FOSSASystems/FOSSASAT-1/Hardware/Pictures/a31cf8a4eafdad409a6d113227be1326.jpg

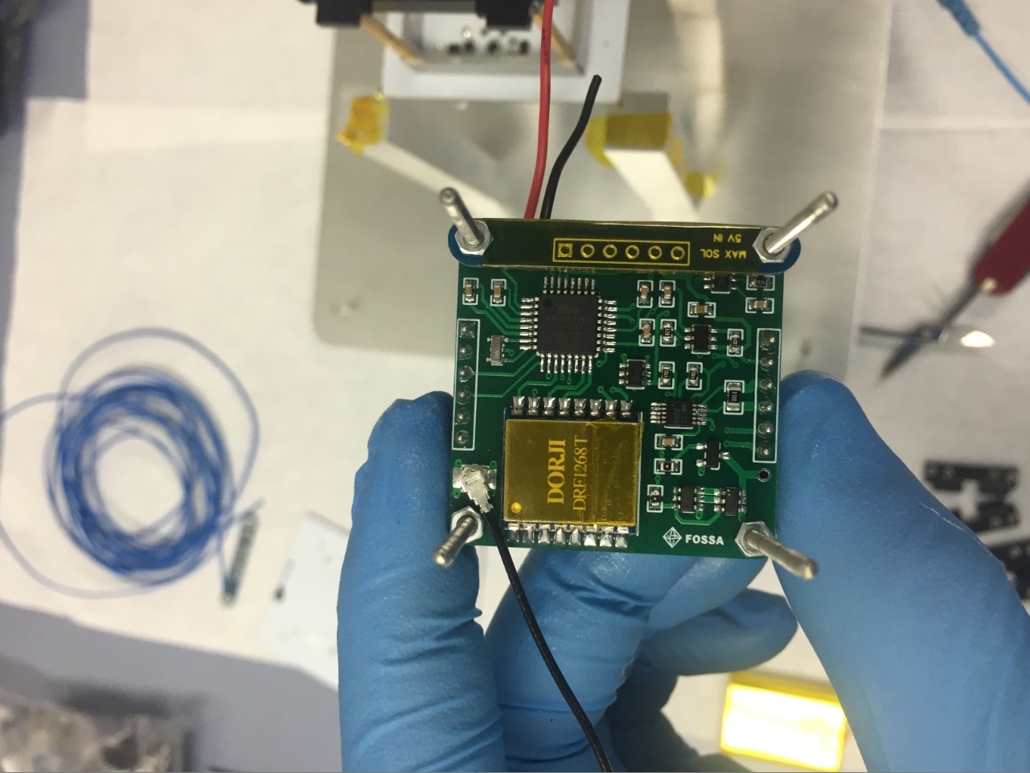
Hardware/Pictures/a31cf8a4eafdad409a6d113227be1326.jpg
