FOSSASystems/FOSSASAT-1/Hardware/Pictures/7ddb9faa-3a29-4a0a-8007-f152b679b4c5.jpg

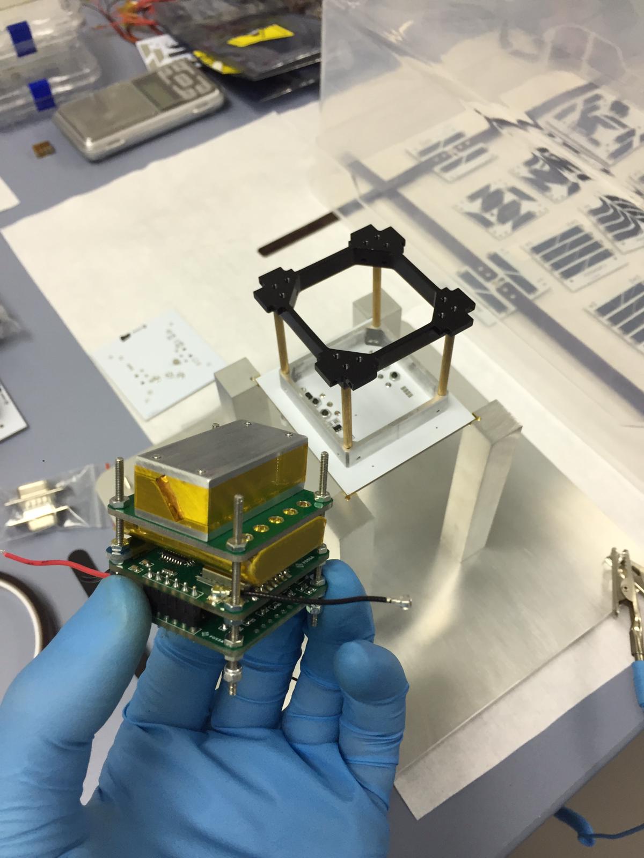
Hardware/Pictures/7ddb9faa-3a29-4a0a-8007-f152b679b4c5.jpg
