FOSSASystems/FOSSASAT-1/Hardware/Passive Attitude Stab/README.md

Two 3x10mm cylindrical magnets are held in the ballast at 55º to compensate for magnetic inclination of Spain. Four MuMetal strips are held on the side pcbs.
