FOSSASystems/FOSSASAT-1/Hardware/Power/README.md

An SPV1040 will be used to regulate the incoming voltage from 14 solar panels with MPPT for float charging, each with 8 trisol X 2.3v 14.6mw solar cells. Corresponding bypass and blocking diodes are used. A 3.7v Li-Ion 1000mah battery will be used. A regulated 3.3v bus will is supplied by a Linear Voltage regulator.
