FOSSASystems/FOSSASAT-1/Code/Documentation/Ground Station/doxygen documentation/latex/ground__station_8cpp__incl.pdf

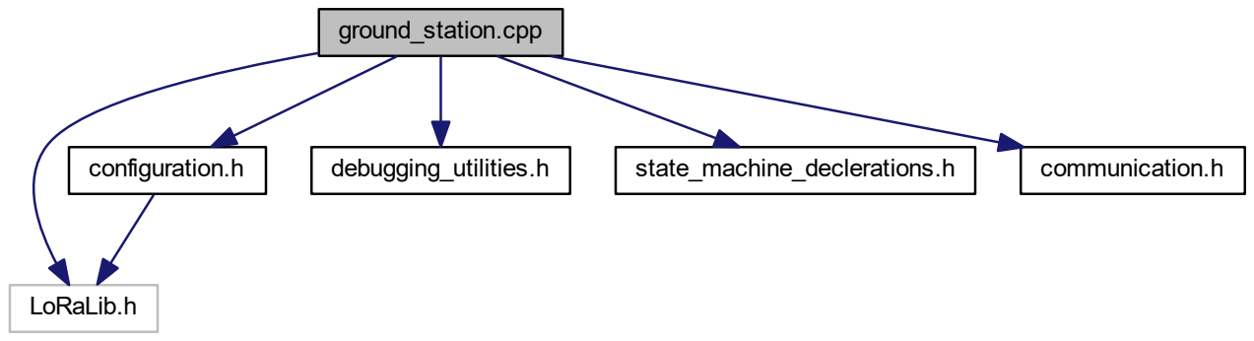
[picture p9: figure]
ground_station.cpp; LoRaLib.h; configuration.h; debugging_utilities.h; state_machine_declerations.h; communication.h
