FOSSASystems/FOSSASAT-1/Code/Documentation/Ground Station/doxygen documentation/latex/communication_8cpp__incl.pdf

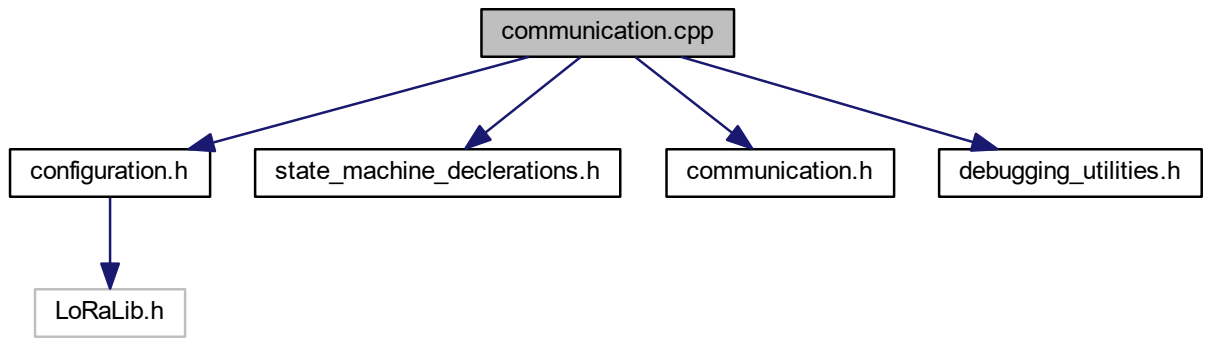
[picture p14: figure]
communication.cpp; configuration.h; state_machine_declerations.h; communication.h; debugging_utilities.h; LoRaLib.h
