FOSSASystems/FOSSASAT-1/FOSSA Documents/Software Documentation/Graphs/FOSSASAT-1.png

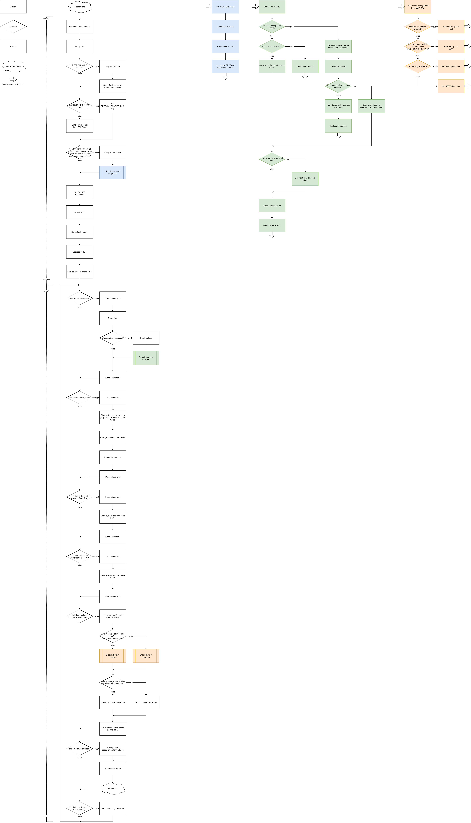
FOSSA Documents/Software Documentation/Graphs/FOSSASAT-1.png
