FOSSASystems/FOSSASAT-1/FOSSA STK/DOPPLER/GRAPHS/FOSSA_DOPPLER_2ELEV.png

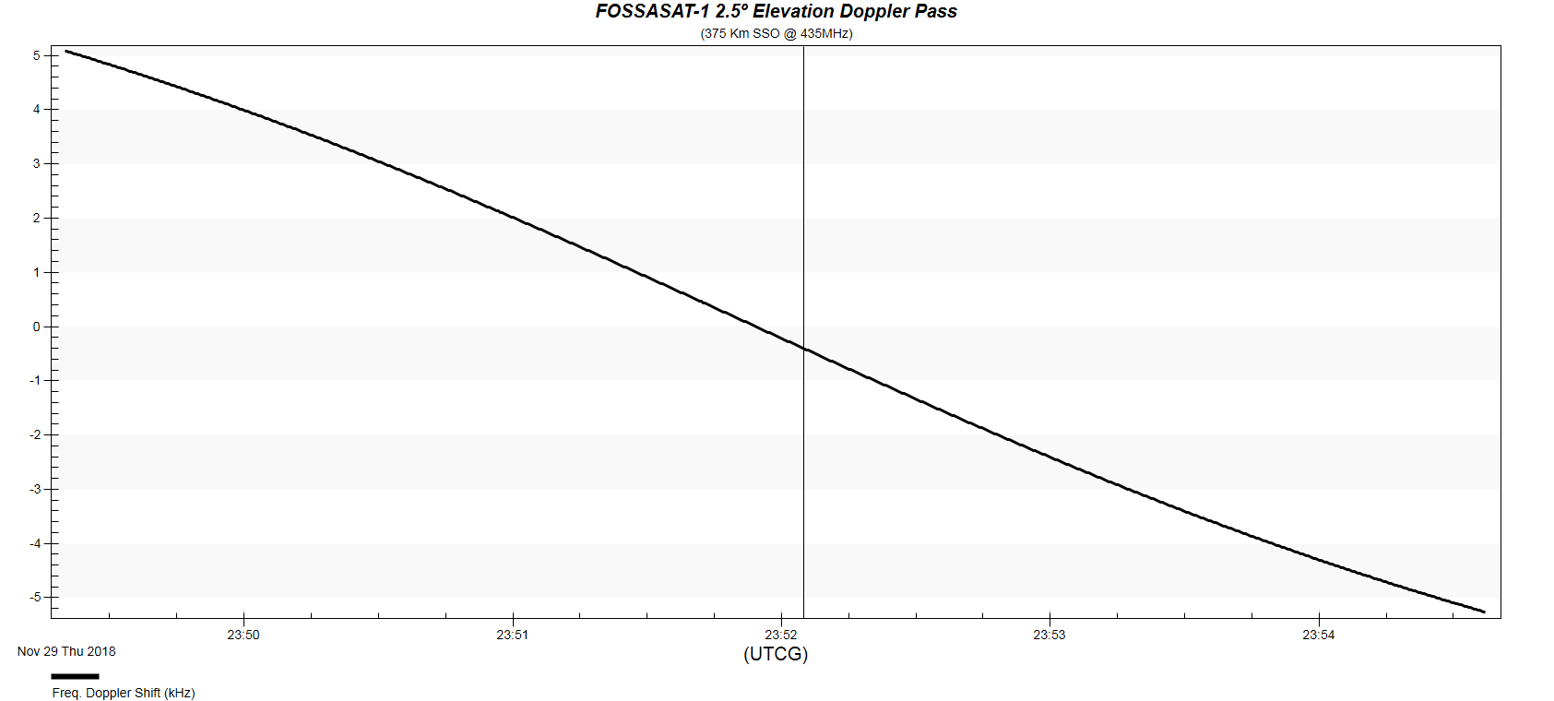
FOSSA STK/DOPPLER/GRAPHS/FOSSA_DOPPLER_2ELEV.png
