FOSSASystems/FOSSASAT-1/FOSSA STK/DOPPLER/GRAPHS/FOSSA_DOPPLER_12ELEV.png

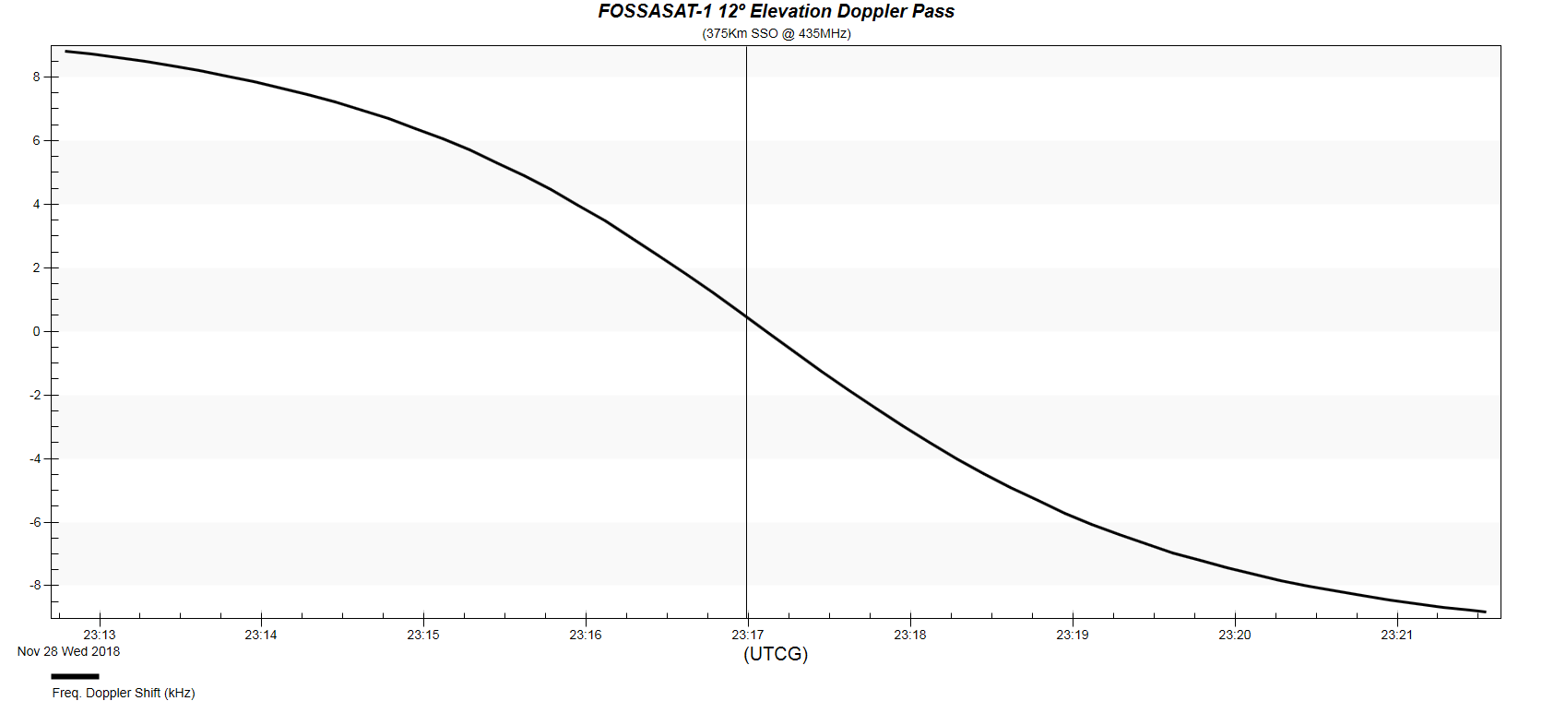
FOSSA STK/DOPPLER/GRAPHS/FOSSA_DOPPLER_12ELEV.png
