FOSSASystems/FOSSASAT-1/FOSSA STK/DOPPLER/GRAPHS/FOSSA_DOPPLER_20ELEV.png

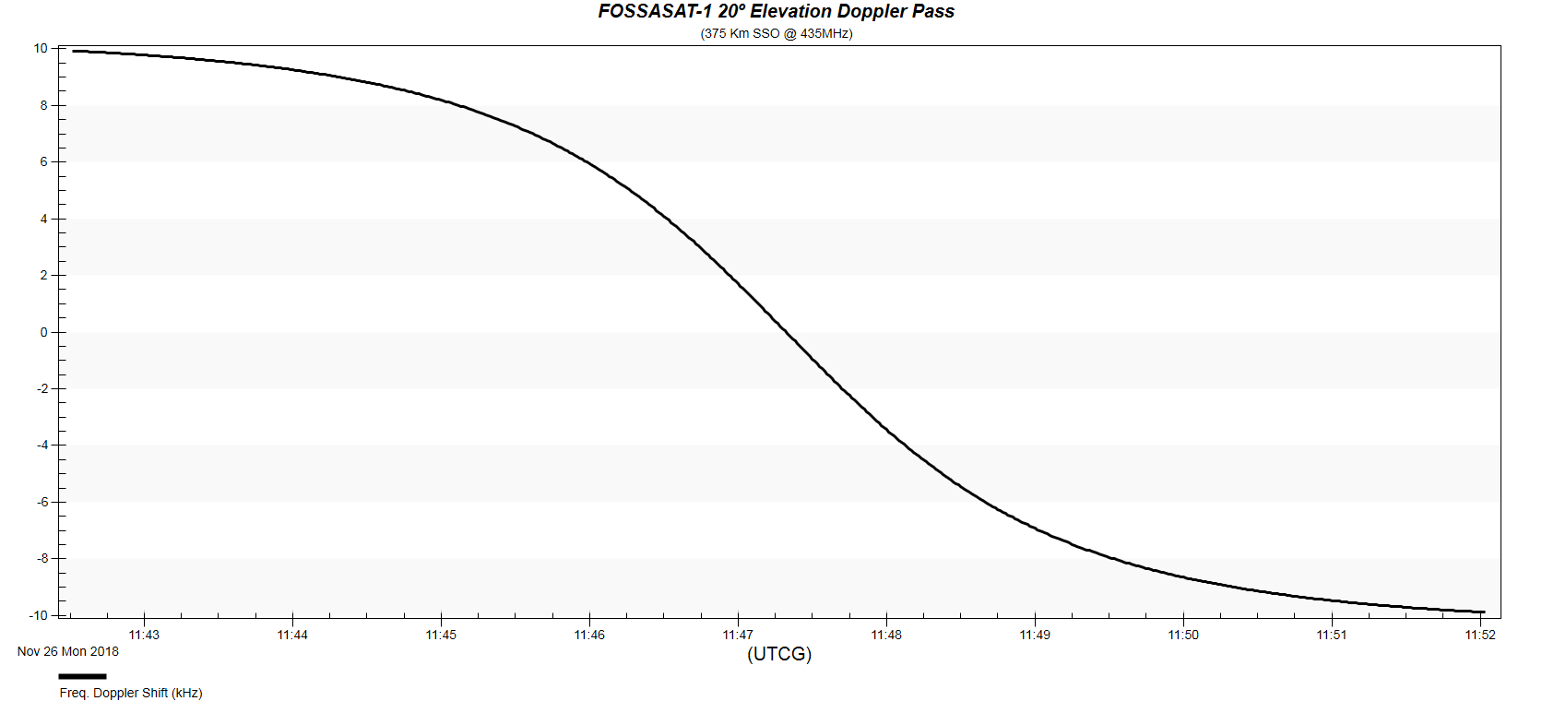
FOSSA STK/DOPPLER/GRAPHS/FOSSA_DOPPLER_20ELEV.png
