FOSSASystems/FOSSASAT-1/FOSSA STK/DOPPLER/RATE OF VARIATION/Doppler Rate 45º Elevation Pass (375 Km @ 435MHz).png

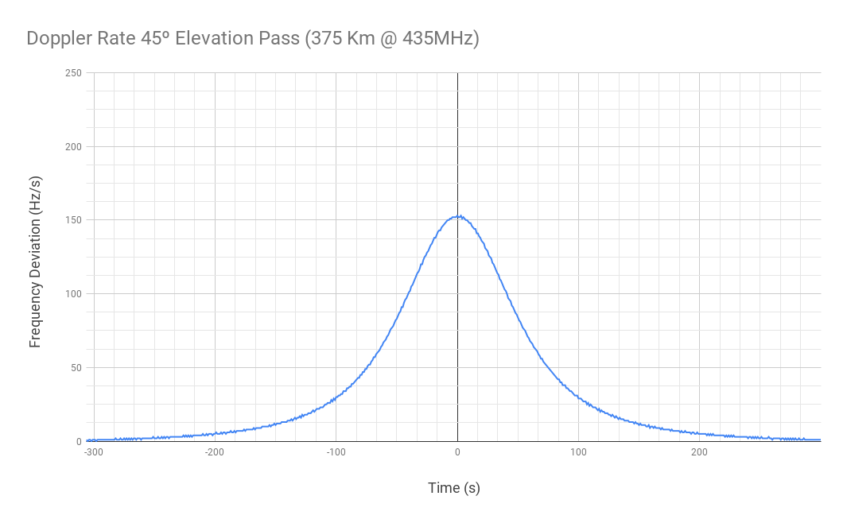
FOSSA STK/DOPPLER/RATE OF VARIATION/Doppler Rate 45º Elevation Pass (375 Km @ 435MHz).png
