FOSSASystems/FOSSASAT-1/FOSSA STK/DOPPLER/RATE OF VARIATION/LoRa Offline Time During Pass (150 Hz).png

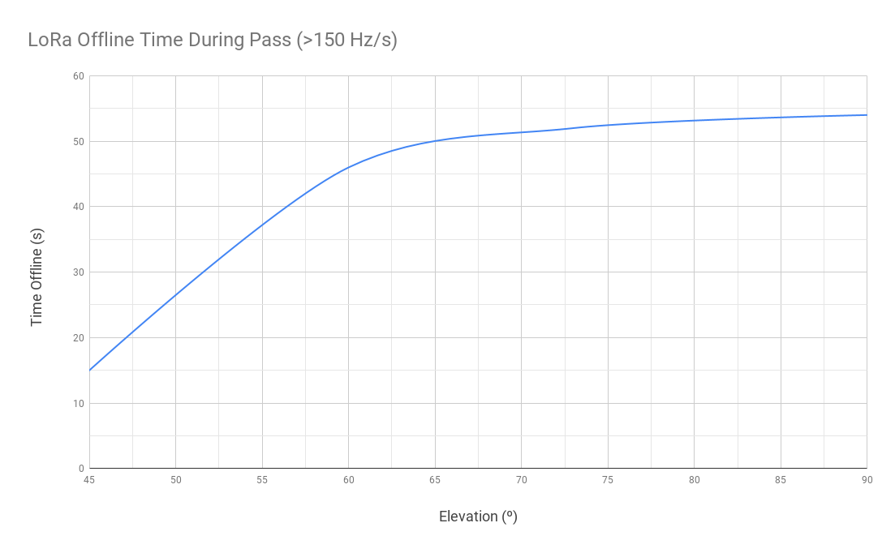
FOSSA STK/DOPPLER/RATE OF VARIATION/LoRa Offline Time During Pass (150 Hz).png
