FOSSASystems/FOSSASAT-1/FOSSA STK/DOPPLER/RATE OF VARIATION/Max Doppler Variation vs Elevation (375 Km SSO @ 435MHz) (3).png

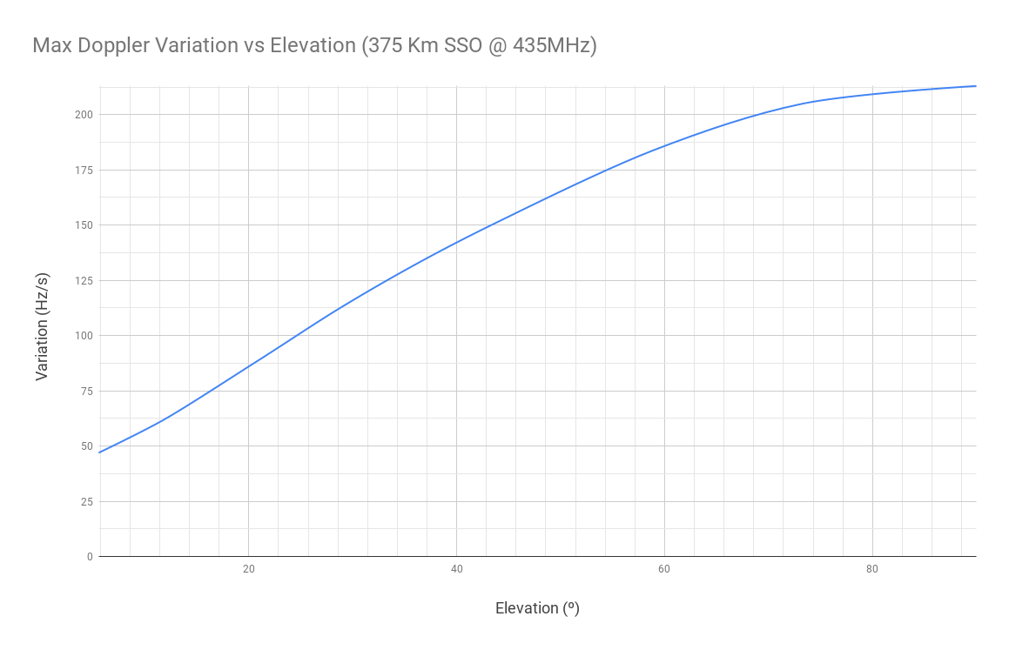
FOSSA STK/DOPPLER/RATE OF VARIATION/Max Doppler Variation vs Elevation (375 Km SSO @ 435MHz) (3).png
