FOSSASystems/FOSSASAT-1/Hardware/Passive Attitude Stab/66231514_591075714632292_2286305018300596224_n.jpg

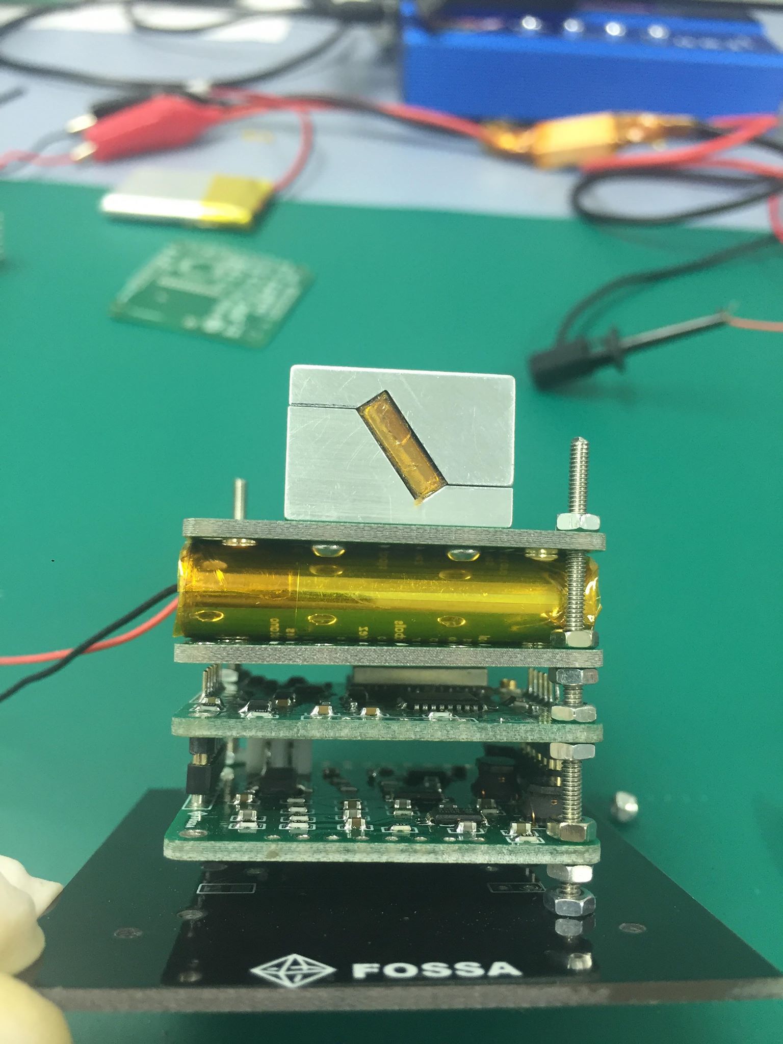
Hardware/Passive Attitude Stab/66231514_591075714632292_2286305018300596224_n.jpg
