FOSSASystems/FOSSASAT-1/Hardware/Pictures/D-E7dWRXkAIltqa.jpg

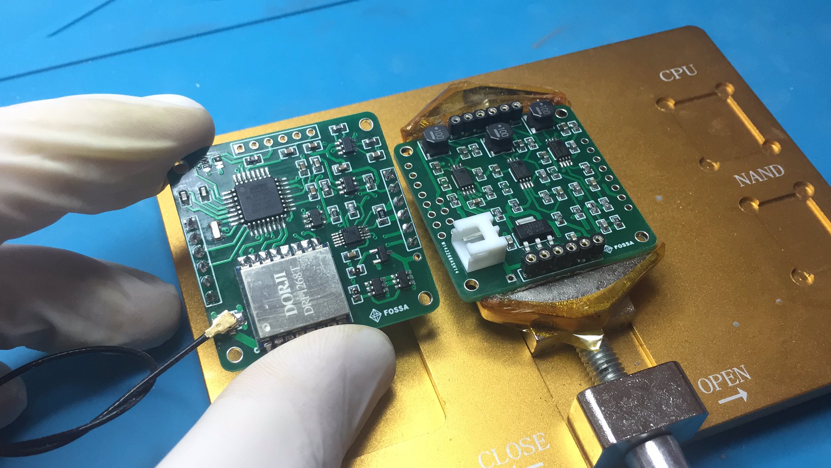
Hardware/Pictures/D-E7dWRXkAIltqa.jpg
