FOSSASystems/FOSSASAT-1/Hardware/Pictures/IMG_2864.JPG

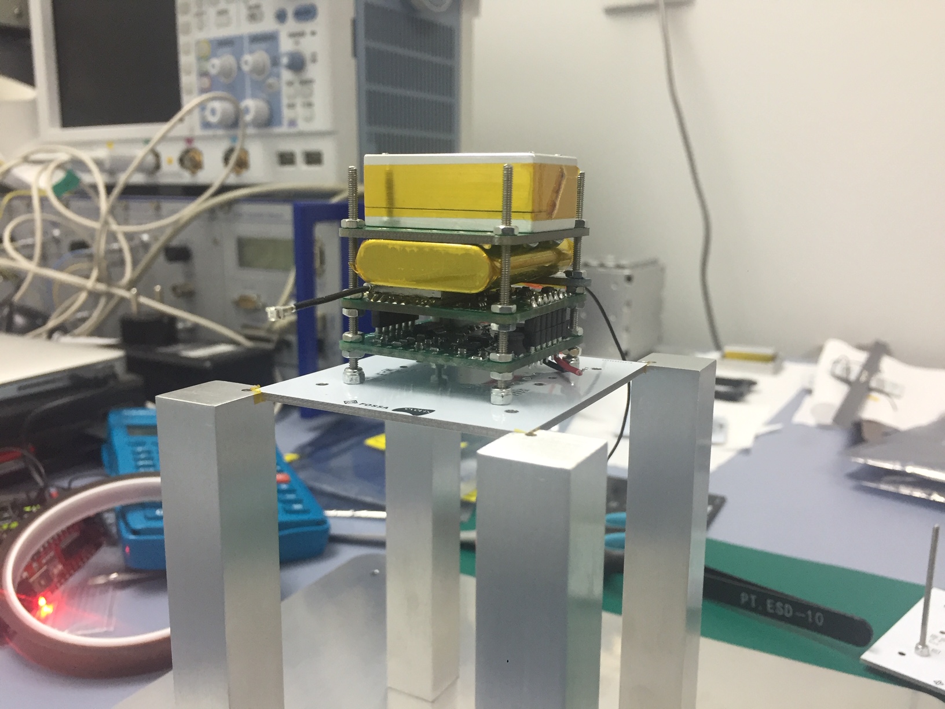
Hardware/Pictures/IMG_2864.JPG
