FOSSASystems/FOSSASAT-1/Hardware/Power/MPPT simulation.png

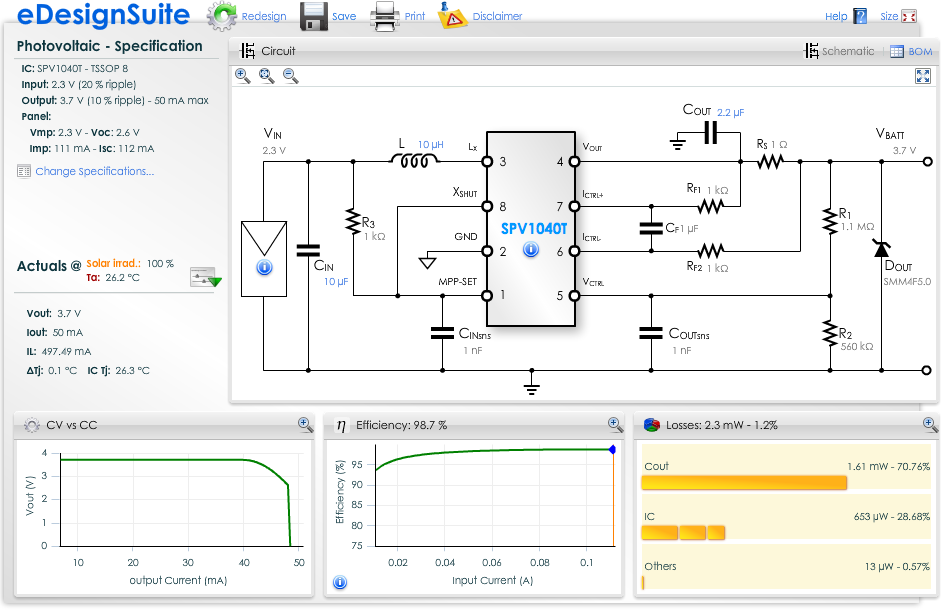
Hardware/Power/MPPT simulation.png
