FOSSASystems/FOSSASAT-1/Hardware/Power/MMPT_BOM_FOSSASAT [With Comments].xlsx

ID | Name | Designator | Footprint | Quantity | Manufacturer Part | Manufacturer | Unit Price | Line Price | Mounted | Mouser | Datasheet | Comments
1 | SPV1040 | U1,U2,U3 | TSSOP-8 | 3 | SPV1040T | STMicroelectronics | £2.39 | £7.17 | Yes | https://www.mouser.co.uk/ProductDetail/STMicroelectronics/SPV1040T?qs=sGAEpiMZZMsSm7LhMeloEF%2fl9Oa9cyhP | https://www.mouser.co.uk/datasheet/2/389/spv1040-974182.pdf | CM: TJ = -40 °C to 125 °C
2 | Header-Male-2.54_1x4 | H1,H2,H3,H4,H5 | 210S-1X4P | 5 | 825433-4 | TE Conn | £0.46 | £2.30 | Yes | https://www.mouser.co.uk/ProductDetail/TE-Connectivity-AMP/825433-4 | https://www.mouser.co.uk/datasheet/2/418/NG_CD_825433_S_baseFilename-1262255.pdf | CM: 6.7mm pin height
3 | 1K0 0.1% 125mW | R1,R2_,R2,R6,R7,R8,R12,R13,R14 | 0603 Imperial | 9 | TNPW06031K00BEEA | Vishay | £0.47 | £4.23 | Yes | https://www.mouser.co.uk/ProductDetail/Vishay/TNPW06031K00BEEA | https://www.mouser.co.uk/datasheet/2/427/tnpw_e3-64594.pdf | CM: AECQ200
4 | 150m | R3,R9,R15 | 0603 Imperial | 3 |  |  |  |  | Yes |  |  | CM: 150Mega Ohms is basically open circuit. What is this used for? Will 10M work instead? 150M hard to find.
5 | 180K 0.5% 250mW | R4,R10,R16 | 0603 Imperial | 3 | ERJ-PA3D1803V | Panasonic | £0.28 | £0.84 | Yes | https://www.mouser.co.uk/ProductDetail/Panasonic/ERJ-PA3D1803V | https://www.mouser.co.uk/datasheet/2/315/AOA0000C331-1141874.pdf | CM: AECQ200
6 | 430K | R5,R11,R17 | 0603 Imperial | 3 | ERJ-PA3F4303V | Panasonic | £0.93 | £2.79 | Yes | https://www.mouser.co.uk/ProductDetail/Panasonic/ERJ-PA3F4303V | https://www.mouser.co.uk/datasheet/2/315/AOA0000C331-1141874.pdf | CM: AECQ200
7 | D_ZENERA | D1,D2,D3 | DO-222AA | 3 | SMM4F5.0A-TR | STMicroelectronics | £0.41 | £1.23 | Yes | https://www.mouser.co.uk/ProductDetail/STMicroelectronics/SMM4F50A-TR | https://www.mouser.co.uk/datasheet/2/389/smm4f-955285.pdf | CM: This is a TVS Diode for Surge suppression. It is typically used on inputs to deal with Lightning and ESD.
8 | JST XH | CN1 | JST XH 2.5-2 Pin | 1 | JST XH 2.5-2 Pin | Generic |  |  | Yes |  |  | CM: What is this part?!
9 | Header-Male-2.54_1x6 | P1,P3,P4 | HDR-6X1/2.54 | 3 | 825433-6 | TE Conn | £0.76 | £2.28 | Yes | https://www.mouser.co.uk/ProductDetail/TE-Connectivity-AMP/825433-6 | https://www.mouser.co.uk/datasheet/2/418/NG_CD_825433_S_baseFilename-1262311.pdf | CM: Is 6.7mm pin length enough?
10 | Header-Female-2.54_1x2 | P2 | HDR-1X2/2.54 | 1 | 825433-2 | TE Conn | £0.33 | £0.33 | Yes | https://www.mouser.co.uk/ProductDetail/TE-Connectivity/825433-2 | https://www.mouser.co.uk/datasheet/2/418/NG_CD_825433_S_baseFilename-672955.pdf | CM: Is 6.7mm pin length enough?
11 | XC6210B332MR | U4 | SOT-23-5 | 1 | XC6210B332MR | TOREX | £0.66 | £0.66 | Yes | https://www.mouser.co.uk/ProductDetail/Torex-Semiconductor/XC6210B332MR-G | https://www.torexsemi.com/file/xc6210/XC6210.pdf | CM: A smaller package is available with a big ground plane pad. Looks better.
12 | Header-Male-2.54_1x1 | P3 | HDR-1X1/2.54 | 1 |  |  |  |  | Yes |  |  | CM: Not worth buying a single header. Just cut some of the bigger ones we have. To be honest we should be doing that with all of them anyway.
13 | 10uF 20% 10V X5R | C17,C9,C10 | 0603 Imperial | 3 | LMK107BBJ106MAHT | Taiyo Yuden | £0.39 | £1.17 | Yes | https://www.mouser.co.uk/ProductDetail/Taiyo-Yuden/LMK107BBJ106MAHT | https://www.mouser.co.uk/datasheet/2/396/mlcc02_e-1307760.pdf | CM: AEC Q200. If these are just for smoothing, they will be fine. Anything else might be a problem.
14 | 1nF 1% 100V C0G/NP0 | C1,C2,C7,C8,C11,C12 | 0603 Imperial | 6 | C0603C102F1GACAUTO | KEMET | £0.96 | £5.76 | Yes | https://www.mouser.co.uk/ProductDetail/KEMET/C0603C102F1GACAUTO | https://www.mouser.co.uk/datasheet/2/212/KEM_C1022_C0G_AUTO_SMD-1093282.pdf | CM: AEC Q200.Top of the line. This cap is amazing.
15 | 1uF 20% 10V X7R | C3,C6,C13,C15 | 0603 Imperial | 4 | C0603C105M8RACAUTO | KEMET | £0.35 | £1.40 | Yes | https://www.mouser.co.uk/ProductDetail/KEMET/C0603C105M8RACAUTO | https://www.mouser.co.uk/datasheet/2/212/KEM_C1023_X7R_AUTO_SMD-1093309.pdf | CM: AEC Q200. Low stock.
16 | 15uF 20% 10V X5R | C4,C5,C14 | 0603 Imperial | 3 | C1608X5R1A156M080AC | TDK | £0.39 | £1.17 | Yes | https://www.mouser.co.uk/ProductDetail/TDK/C1608X5R1A156M080AC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 | https://www.mouser.co.uk/datasheet/2/400/lcc_commercial_general_en-837201.pdf | CM: Cannot get 15uF in AECQ200. Can get 10uF or 22uF - can we change pad size or capacitance? Stuck with this X5R, +85*C 10V piece of crap.
17 | 10uH 20% 72.8mOhm | L3,L1,L2 | 5040 | 3 | NRS5040T100MMGJV | Taiyo Yuden | £0.43 | £1.29 | Yes | https://www.mouser.co.uk/ProductDetail/Taiyo-Yuden/NRS5040T100MMGJV | https://www.mouser.co.uk/datasheet/2/396/wound04_hq_e-1313823.pdf | CM: AEC Q200. -25*C only! Need a hardier part.
