FOSSASystems/FOSSASAT-1/Hardware/Beacon/BOM_PCBBeaconv4_20191204195310.csv

ID | Name | Designator | Footprint | Quantity | Manufacturer Part | Manufacturer | Supplier | Supplier Part | Mounted
1 | 150K | R4 | 0805' | 1 | CR0805F81503G | LIZ | LCSC | C101484
2 | 100nF | C8,C3,C9,C7,C4,C6,C5,C1 | 0603' | 8 | 0603B225K160NT | FH | LCSC | C43922
3 | 1uF | C10,C2 | 0603' | 2 | 0603B225K160NT | FH | LCSC | C43922
4 | TMP100NA/3KG4 | U3 | SOT-23-6 | 1 | TMP100NA/3KG4 | TI | LCSC | C181417
5 | SX1278T | U8 | SX1262/68 | 1 | ?
6 | PROGRAM HEADER | P3 | HDR-6X1/2.54 | 1 | Header-Male-2.54_1x6 | BOOMELE | LCSC | C37208
7 | MAX6369KA+T | U7 | SOT-23-8 | 1 | MAX6369KA+T | MAXIM | LCSC | C128613
8 | FDC855N | Q3,Q2 | SUPERSOT-6(SSOT-6) | 2 | FDC653N | FAIRCHILD | LCSC | C10887
9 | JST SH 2 circuits | J1 | JST-SH-S-2 | 1 | SM02B-SRSS-TB | JST
10 | 8MHz | X2 | 3213 | 1 | CSTCE8M00G55A-R0 | MuRata | LCSC | C91587
11 | INA226 | U2 | MSOP-10 | 1 | INA226AIDGSR | TI | LCSC | C49851
12 | 10K | R7,R6,R9,R11 | 0603' | 4 | 0603WAJ0624T5E | UniOhm | LCSC | C26002
13 | 100K | R3,R2 | 0603' | 2 | 0603WAJ0624T5E | UniOhm | LCSC | C26002
14 | RLIM | R5,R10 | 0603' | 2 | 0603WAJ0624T5E | UniOhm | LCSC | C26002
15 | 4.7K | R1,R8 | 0603' | 2 | 0603WAJ0624T5E | UniOhm | LCSC | C26002
16 | Atmega 328p | U1 | TQFP-32 | 1 | Atmega 328p smd |  | EasyEDA | undefined | Yes
17 | TPS2553DBVR | U6,U5 | SOT-23-6 | 2 | TPS2553DBVR | TI | LCSC | C55266
18 | FDN359BN | Q1 | SOT-23(SOT-23-3) | 1 | FDN359BN | FAIRCHILD | LCSC | C128794
19 | U.FL-R | JP1 | U.FL-R-SMT-1(10) | 1 | U.FL-R-SMT-1(10) | HRS | LCSC | C88373
20 | Header-Female-2.54_1x6 | P1,P2 | HDR-6X1/2.54 | 2 | Female header 1*6p | BOOMELE | LCSC | C40877
