FOSSASystems/FOSSASAT-1/Hardware/Power/MMPT_BOM_FOSSASAT.xlsx

ID | Name | Designator | Footprint | Quantity | Manufacturer Part | Manufacturer | Price | Mouser | Mounted
1 | SPV1040 | U1,U2,U3 | TSSOP-8 | 3 | 511-SPV1040T | STmicroelectronics | 2.69 | 511-SPV1040T | Yes
2 | Header-Male-2.54_1x4 | H1,H2,H3,H4,H5 | 210S-1X4P | 5 |  |  |  |  | Yes
3 | 1k | R1,R2_,R2,R6,R7,R8,R12,R13,R14 | 0603 | 9 | ERA-1AEB102C | Panasonic | 0.57 | 667-ERA-1AEB102C | Yes
4 | 150mohm | R3,R9,R15 | 0603 | 3 | ERA-1AEB151C | Panasonic | 0.527 | 667-ERA-1AEB151C | Yes
5 | 180kohm | R4,R10,R16 | 0603 | 3 | ERJ-1GNJ181C | Panasonic | 0.179 | 667-ERJ-1GNJ181C | Yes
6 | 430kohm | R5,R11,R17 | 0603 | 3 | ERJ-1GNF4300C | Panasonic | 0.417 | 667-ERJ-1GNF4300C | Yes
7 | D_ZENERA | D1,D2,D3 | DO-222AA | 3 | 511-SMM4F5.0A-TR | STmicroelectronics | 0.46 | 511-SMM4F5.0A-TR | Yes
8 | JST XH | CN1 | JST XH 2.5-2 Pin | 1 | JST XH 2.5-2 Pin | Generic |  |  | Yes
9 | Header-Male-2.54_1x6 | P4,P1 | HDR-6X1/2.54 | 2 |  |  |  |  | Yes
10 | Header-Female-2.54_1x2 | P2 | HDR-1X2/2.54 | 1 |  |  |  |  | Yes
11 | XC6210B332MR | U4 | SOT-23-5 | 1 | XC6210B332MR | TOREX | 0.74 | 865-XC6210B332MR-G | Yes
12 | Header-Male-2.54_1x1 | P3 | HDR-1X1/2.54 | 1 |  |  |  |  | Yes
13 | 10uf | C17,C9,C10 | 0603 | 3 | AMK107BBJ106MK-T (https://www.mouser.es/ProductDetail/Taiyo-Yuden/AMK107BBJ106MK-T) | Taiyo Yuden | 0.383 | 963-AMK107BBJ106MK-T | Yes
14 | 1nf | C1,C2,C7,C8,C11,C12 | 0603 | 6 | EMK107SD103KA-T | Taiyo Yuden | 0.257 | 963-EMK107SD103KA-T | Yes
15 | 1uf | C3,C6,C13,C15 | 0603 | 4 | AMK063ABJ105MP-F | Taiyo Yuden | 0.238 | 963-AMK063ABJ105MP-F | Yes
16 | 15uf | C4,C5,C14 | 0603 | 3 | C1608X5R1A156M080AC | TDK | 0.442 | 810-C1608X5R1A156M | Yes
17 | 10uH | L3,L1,L2 | 5040 | 3 | 963-NRS5040T100MMGJV | Taiyo Yuden | 0.485 | 963-NRS5040T100MMGJV | Yes
