FOSSASystems/FOSSASAT-1/Hardware/Frame/STRUCTURE UPPER FOSSASAT-1 v1.step

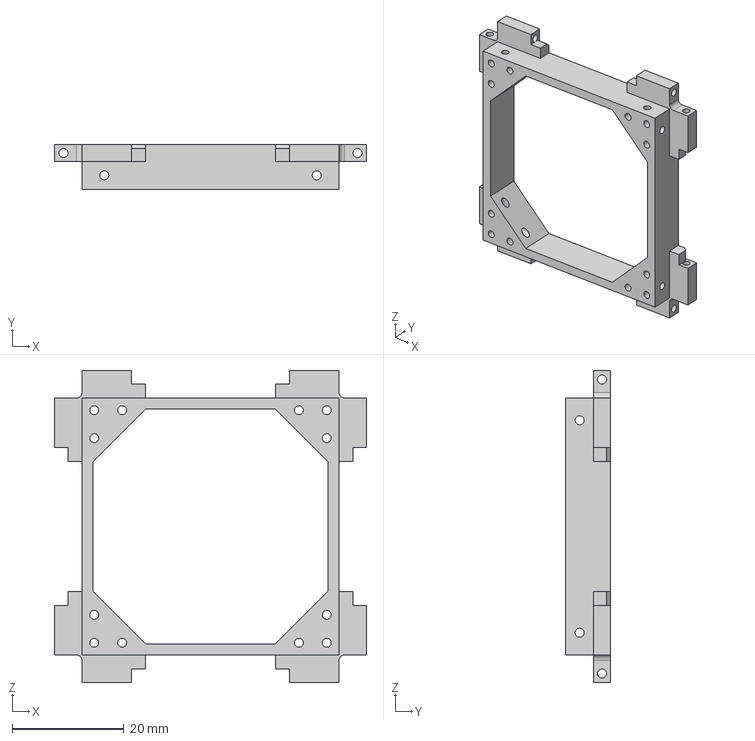
[picture p31: CAD file, 2019-12-04]
Hardware/Frame/STRUCTURE UPPER FOSSASAT-1 v1.step
55.8 x 8.00 x 55.8 mm
