FOSSASystems/FOSSASAT-1/Hardware/Passive Attitude Stab/MagnetBase1.step

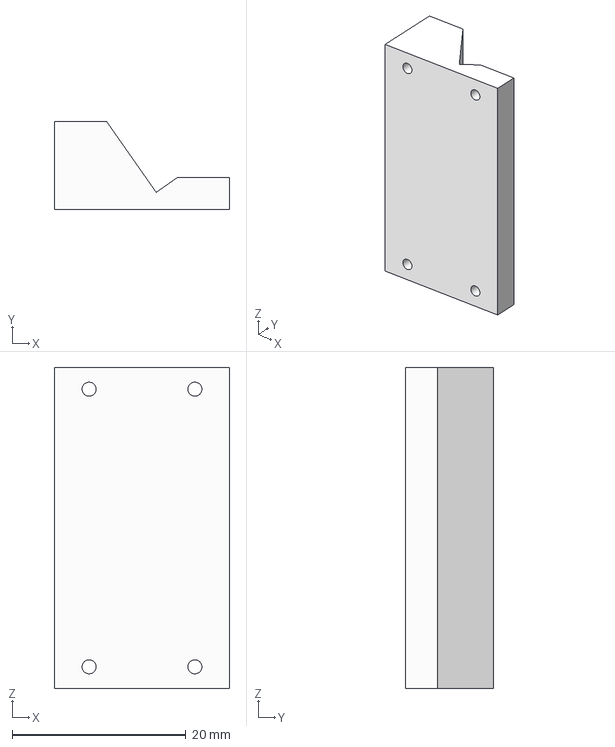
[picture p32: CAD file, 2019-12-04]
Hardware/Passive Attitude Stab/MagnetBase1.step
20.2 x 10.2 x 37.0 mm
