FOSSASystems/FOSSASAT-1/Hardware/Frame/stucture lower fossasat v4.step

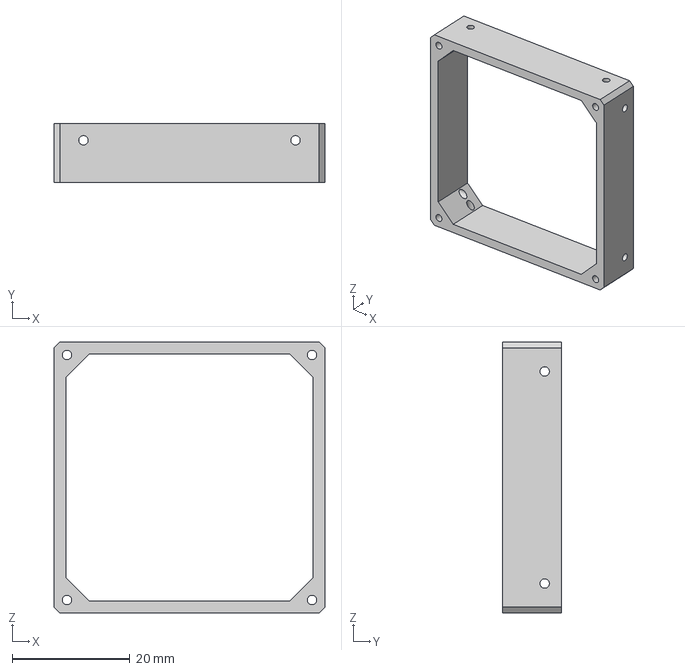
[picture p33: CAD file, 2019-12-04]
Hardware/Frame/stucture lower fossasat v4.step
46.0 x 10.0 x 46.0 mm
