FOSSASystems/FOSSASAT-1/(list of files, cad)

Other CAD files:
Hardware/Deployables/Hingedouble.f3d
Hardware/Frame/stucture lower fossasat v2.f3d
