FOSSASystems/FOSSASAT-1/(threads)

Thread 1 (2018-08-26):

RTTY support in KiteLib

jgromes, 2018-08-26:
Hi @Bambofy, did you know that KiteLib supports RTTY directly? You don't have to implement it yourself ;)

All you have to do to change from LoRaLib to KiteLib is to replace the included file
```c++
#include <KiteLib.h>
```
and the constructor
```c++
SX1278 lora = new Module(cs, dio0, dio1);
```

Because KiteLib is built on top of LoRaLib, nothing in the API changes, so those two things are literally the only two lines of code you have to change.

After that, you can use the RTTY just as easily as Arduino Serial port:
```c++
RTTYClient rtty(&lora);

rtty.begin(freq, shift, baudRate, dataBits, stopBits);
rtty.println("Hello World!");
```

jgromes, 2018-08-30:
Exactly the same way as in LoRaLib:

```c++
#include <KiteLib.h>

SX1278 lora = Kite.ModuleA;
RTTYClient rtty(&lora);

void setup() {

}

void loop() {
  // send LoRa packet
  lora.begin();
  lora.transmit("Hello World!");
  delay(1000);

  // send FSK packet
  lora.beginFSK();
  lora.transmit("Hello World!");
  delay(1000);

  // begin RTTY at 434 MHz, 183 shift, 45 baud, 8 data bits, 1 stop bit
  rtty.begin(434, 183, 45);

  // idle condition lead-in for 500 ms
  rtty.idle();
  delay(500);

  // send RTTY data "Hello World!\r\n"
  rtty.println("Hello World!");

  // turn off transmitter
  lora.standby();
  delay(1000);
}
```

Closed 2019-10-18.

Thread 2 (2019-08-16):

PDFs of PCB designs are not source code

Snowda, 2019-08-16:
PDFs aren't even usable with manufacturers. That would require the gerber files.

But even then, the hardware is not currently open source without the original Altium/Kicad/Eagle/etc. files that can be modified or improved upon by outside individuals.

marzoukali, 2019-08-22:
I was concerned about the same point, I want to make a big contribution there and i went through the whole code but i was wonder if we can create an easy integration test so we can solve the hardware closed source problem.

juliantech5, 2019-09-07:
Hey all, excuse the delay. Been so busy getting the satellite built and tested that I have not had the chance to update. I will upload the gerber files of the last models and the latest source code soon.

vinicentus, 2019-12-04:
Is there a timeline for this?

juliantech5, 2019-12-04:
uploaded latest gerbers

peterus, 2019-12-14:
wanted to check with JLCPCB if everything is here and what it would cost to order some PCBs with SMT components added to the PCBs. Looks like the Pick&Place File is missing. @juliantech5 can you please upload the file too? Thanks!

Closed 2019-12-04.

Thread 3 (2019-10-25):

No need to wait after Wire.requestFrom() and it should not be used together with Wire.beginTransmission().

Koepel, 2019-10-25:
In the file "FOSSASAT-1/Code/FossaSat1/power_control.cpp", in the function "Power_Control_INA2256_Check()", there is Wire.beginTransmission() just before the Wire.requestFrom(). That Wire.beginTransmission() may be removed.
The timeout after the Wire.requestFrom() may be removed as well.

Explanation: [Common-mistakes](https://github.com/Koepel/How-to-use-the-Arduino-Wire-library/wiki/Common-mistakes), number 1 and 3.

This section:
```
  // try to read
  Wire.beginTransmission(INA_ADDR);
  Wire.requestFrom((uint8_t)INA_ADDR, (uint8_t)2);
  uint32_t start = millis();
  while(!Wire.available()) {
    if(millis() - start >= INA_TIMEOUT) {
      // timed out
      return(false);
    }
  }
```
can be reduced to:
```
  // try to read
  Wire.requestFrom((uint8_t)INA_ADDR, (uint8_t)2);
```
If you want to check if the data was received, then you can do this:
```
  // try to read
  Wire.requestFrom((uint8_t)INA_ADDR, (uint8_t)2);
  if(Wire.available() != 2) {
    return(false);
  }
```
or this:
```
  // try to read
  if(Wire.requestFrom((uint8_t)INA_ADDR, (uint8_t)2) != 2)
    return(false);
```

jgromes, 2019-10-25:
You're right, there is some redundancy, though it doesn't affect the intended function. The code was adapted from this library, you might want to open another issue there: https://github.com/jarzebski/Arduino-INA226/blob/968a684ed44d0e076a90c93feed07e834b5fdad4/INA226.cpp#L298

On a side note, is there a non-blocking equivalent of `Wire.requestFrom()`?

Koepel, 2019-10-25:
In this case the extra code is harmless, but others could think that it is needed.

I have given up on jarzebski. See for example this: https://github.com/jarzebski/Arduino-MPU6050/issues/4 I tried to convince him that it is better to write code without bugs, then I tried to be annoying, but nothing helps.

There is a library for the Teensy boards that have non-blocking I2C functions and there is a I2C library that uses DMA, but those functions are not compatible with the Arduino Wire library.

Thread 4 (2019-11-04):

Error compiling: not declared in this scope

K4KDR, 2019-11-04:
Thank you for the updates to the Arduino code for FossaSat-1!

Using commit 70ef487, I get the following error.  Please note that 'FOSSA-Comms' is up-to-date as of the current commit which is 1fc86e2 at the date of this post.

Thank you very much!

-Scott,  K4KDR

```
/home/k4kdr/Arduino/libraries/FOSSA-Comms/src/FOSSA-Comms.cpp: In function 'int16_t FCP_Get_OptData_Length(char*, uint8_t*, uint8_t, const uint8_t*, const char*)':
/home/k4kdr/Arduino/libraries/FOSSA-Comms/src/FOSSA-Comms.cpp:57:5: error: 'aes128_dec_multiple' was not declared in this scope
     aes128_dec_multiple(key, encSection, encSectionLen);
     ^~~~~~~~~~~~~~~~~~~
/home/k4kdr/Arduino/libraries/FOSSA-Comms/src/FOSSA-Comms.cpp: In function 'int16_t FCP_Get_OptData(char*, uint8_t*, uint8_t, uint8_t*, const uint8_t*, const char*)':
/home/k4kdr/Arduino/libraries/FOSSA-Comms/src/FOSSA-Comms.cpp:141:5: error: 'aes128_dec_multiple' was not declared in this scope
     aes128_dec_multiple(key, encSection, encSectionLen);
     ^~~~~~~~~~~~~~~~~~~
/home/k4kdr/Arduino/libraries/FOSSA-Comms/src/FOSSA-Comms.cpp: In function 'int16_t FCP_Encode(uint8_t*, char*, uint8_t, uint8_t, uint8_t*, const uint8_t*, const char*)':
/home/k4kdr/Arduino/libraries/FOSSA-Comms/src/FOSSA-Comms.cpp:245:5: error: 'aes128_enc_multiple' was not declared in this scope
     aes128_enc_multiple(key, encSection, encSectionLen + paddingLen);
     ^~~~~~~~~~~~~~~~~~~
Multiple libraries were found for "RadioLib.h"
 Used: /home/k4kdr/Arduino/libraries/RadioLib
Multiple libraries were found for "SPI.h"
 Used: /home/k4kdr/Downloads/arduino/arduino-1.8.10/hardware/arduino/avr/libraries/SPI
Multiple libraries were found for "SoftwareSerial.h"
 Used: /home/k4kdr/Downloads/arduino/arduino-1.8.10/hardware/arduino/avr/libraries/SoftwareSerial
Multiple libraries were found for "FOSSA-Comms.h"
 Used: /home/k4kdr/Arduino/libraries/FOSSA-Comms
Multiple libraries were found for "AESLib.h"
 Used: /home/k4kdr/Arduino/libraries/AESLib
Using library RadioLib at version 1.7.0 in folder: /home/k4kdr/Arduino/libraries/RadioLib
Using library SPI at version 1.0 in folder: /home/k4kdr/Downloads/arduino/arduino-1.8.10/hardware/arduino/avr/libraries/SPI
Using library SoftwareSerial at version 1.0 in folder: /home/k4kdr/Downloads/arduino/arduino-1.8.10/hardware/arduino/avr/libraries/SoftwareSerial
Using library FOSSA-Comms at version 1.0.0 in folder: /home/k4kdr/Arduino/libraries/FOSSA-Comms
Using library AESLib at version 1.0.5 in folder: /home/k4kdr/Arduino/libraries/AESLib
exit status 1
Error compiling for board Arduino/Genuino Uno.
```

jgromes, 2019-11-04:
Judging by this:

```
Multiple libraries were found for "RadioLib.h"
 Used: /home/k4kdr/Arduino/libraries/RadioLib
Multiple libraries were found for "SPI.h"
 Used: /home/k4kdr/Downloads/arduino/arduino-1.8.10/hardware/arduino/avr/libraries/SPI
Multiple libraries were found for "SoftwareSerial.h"
 Used: /home/k4kdr/Downloads/arduino/arduino-1.8.10/hardware/arduino/avr/libraries/SoftwareSerial
Multiple libraries were found for "FOSSA-Comms.h"
 Used: /home/k4kdr/Arduino/libraries/FOSSA-Comms
Multiple libraries were found for "AESLib.h"
 Used: /home/k4kdr/Arduino/libraries/AESLib
```

there's something wrong with your libraries or Arduino IDE installation/configuration. Please make sure Arduino IDE and all libraries are installed correctly.

K4KDR, 2019-11-04:
Thank you very much for the guidance!

Arduino IDE was re-installed and FOSSASystems repositories & required libraries re-downloaded. Pulled commit a5fddca; code verifies & uploads without error.

Many thanks for your support!

Closed 2019-11-05.

Thread 6 (2019-11-28):

Retransmitted message can contain additional characters

K4KDR, 2019-11-28:
Question or possible issue ref. the command:

`r - send message to be retransmitted`

When a simple string is transmitted, the Simulator reply is initially as expected:

```
00:03:38.314 -> Got repeated message:
00:03:38.366 -> hello
```

... but when you send additional messages, the reply can include extra characters:

```
00:05:05.545 -> Got repeated message:
00:05:05.579 -> hello again⸮⸮⸮&
```

... and the really strange reply comes when a short message is sent AFTER a longer message:

```
00:07:20.852 -> Got repeated message:
00:07:20.852 -> 123456789_123456789_12345ds⸮⸮⸮

00:08:01.194 -> Got repeated message:
00:08:01.229 -> hi there9_12345
```

... perhaps is something in either the GroundStation code or the Simulator code not clearing out a buffer between re-transmitted messages?  Also, in certain circumstances, the re-transmission from the simulator dumps dozens or hundreds of characters - I assume an overflow condition of some kind?

Of course this is not a big deal and I only bring it to your attention in case the spacecraft code behaves like the simulator code in this regard.  NOT a priority, obviously; just wanted to share my observation as we anxiously await the launch.

Great to see so many people registered on the Ground Station site now!

-Scott,  K4KDR

jgromes, 2019-11-28:
Hi Scott, thanks for pointing this out.

In the packet dumps, you can see that the data actually sent over the air is correct. There was an issue  with how the received data is printed in the ground station code - it basically just printed everything in RAM until it hit null byte, which is why you got seemingly random bytes at the end of the printed string.

Should be fixed now.

K4KDR, 2019-11-29:
Yes, working perfectly after the update.

Thanks much!!

Closed 2019-11-28.

Thread 7 (2019-11-30):

Not possible to register

mfalkvidd, 2019-11-30:
Sorry if this is not the right place to report a problem for http://groundstationdatabase.com/registerStation.php but I couldn't find any other place.

I am unable to register. The "Optional" Name if the institution seems to be mandatory, and I am not able to enter a valid gps location. The validation message doesn't offer any information on what it considers valid.

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

Bambofy, 2019-11-30:
Hello, Thanks for reporting this bug,

I have removed the required flag from the institution input box and made sure it is an optional parameter for the database.

The problem with the GPS coordinates is that we have fixed the precision of the numbers to
0.0001'ths so it must be at most, 4 decimal places long.

Thanks, Richard

mfalkvidd, 2019-11-30:
Great. Would it be possible to let the error message mention that, instead of just saying ”invalid”?

juliantech5, 2020-05-02:
@Bambofy  On my end another suggestion is adding a dashboard for the complied data and separating data in sections (ie: battery, messages, temps etc). Oh and adding FOSSASAT-1B/2 options

Bambofy, 2020-05-02:
> @Bambofy On my end another suggestion is adding a dashboard for the complied data and separating data in sections (ie: battery, messages, temps etc). Oh and adding FOSSASAT-1B/2 options

I will look into this asap

Thread 8 (2019-12-09):

Only LSB of batteryChargingCurrent is sent in RTTY

jgromes, 2019-12-09:
Due to a cast from int16_t to uint8_t, only LSB of charging current is sent during RTTY system info transmission:

https://github.com/FOSSASystems/FOSSASAT-1/blob/e9ca4d440e252bebd633d2d2d7eb15c7406ac2bc/Code/FossaSat1/communication.cpp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

Also, current RTTY system info prints out letter shift symbol at the end of each hex-encoded byte. This makes transmission longer than it needs to be (although easier to decode in some cases).

Thread 11 (2019-12-10):

Pin allocations in Simulator are for DIO0 and DIO1

LoRaTracker, 2019-12-10:
The pin allocations for the simulator are;

#define RADIO_DIO0                                      2
#define RADIO_DIO1                                      3
#define RADIO_BUSY                                      9

When using an SX126x, do you need to connect its DIO1 pin to the pin defined as  RADIO_DIO0 ?

jgromes, 2019-12-10:
That's correct, it is written that way because of SX1278 (and because SX1268 starts at DIO1). However, support for SX1278 will be dropped from the simulator anyway (because of the sync word issue, #10).

Thread 13 (2020-04-27):

Fossate-1 current status

GitHubForPP, 2020-04-27:
Hi
I want to ask if Fossate-1 is still working now?

juliantech5, 2020-05-01:
A full report on the mission is being written. FossaSat-1 was last heard in February and entered LoRa-Only transmission due to low power.

Closed 2020-05-02.

Thread 14 (2020-05-03):

AntennaSolarPanel Dimensions Missing

laminekebe, 2020-05-03:
Hi Dears ,

My name is Mouhamadou and I'm Telco student engineer (Final year)  and cubesat/nanosat Enthousiast . I'm using the fossasystem documentation to learn and build one for my TFM.

The dimensions of the Antenna Solar Panel are missing in the gerber file. It produces an error when I try to open it in Kicad and when i try to order in Easy EDA

Regards
Mouhamadou

Thread 15 (2020-05-03):

AntennaSolarPanel Dimensions Missing

laminekebe, 2020-05-03:
Hi Dears ,

My name is Mouhamadou and I'm Telco student engineer (Final year)  and cubesat/nanosat Enthousiast . I'm using the fossasystem documentation to learn and build one for my TFM.

The dimensions of the Antenna Solar Panel are missing in the gerber file. It produces an error when I try to open it in Kicad and when i try to order in Easy EDA

Regards
Mouhamadou

laminekebe, 2020-05-03:
AntenaSolarPanel dimension = 46mm*50mm
SideSolarPanel dimension = 46mm*46mm

Closed 2020-05-03.

Thread 16 (2020-09-13):

s  band Transmeter

subzero1234lx, 2020-09-13:
hi all
Is there any S Band transmetere in maeket that can add to this pico sat?
i searched but only s band transmetere for cube sat is avalable (size pc104 )

Gipsonek, 2020-09-13:
I'm not aware of any S-band transmitters that would fit into PocketQube - I also don't see how one would power it. It's going to draw a couple amps of current to transmit, that's way beyond power capabilites of a 1P PocketQube, probably even beyond 1U CubeSat's power budget.

Thread 17 (2020-10-20):

RFM9X series not supported ?

fraab, 2020-10-20:
I've been struggling to get an Adafruit RFM96 module to work with your code.   One issue appears to be with the sync word 0X0F0F.  Since RadioLib's RFM9x support is based on the SX127x, when you dropped support for the SX127x (issue 10), that also dropped support for the RFM9x family.  May I suggest you update the documentation on Github and in your Communications Guide to reflect this fact.

jgromes, 2020-10-20:
I'm not entirely sure what you're trying to do. If you're trying to get the flight code working with SX127x (RFM9x is nearly identical device/silicon), then you're going to run into a lot more trouble than just the sync word, the whole thing is built around SX126x.

If you're trying to get a ground station running with SX127x, I would advise against using the GroundStation sketch in this repository, as FOSSASAT-1 is no longer operational (and likely already de-orbited). There's an updated version of the ground station sketch for [FOSSASAT-1B](https://github.com/FOSSASystems/FOSSASAT-1B/blob/master/software/manual_test/GroundStation/GroundStation.ino) in which the sync word issue has been resolved. However, those sketches were mainly used in development - for actual ground station operation, I highly recommend this project: https://github.com/G4lile0/ESP32-OLED-Fossa-GroundStation

fraab, 2020-10-21:
Jan,

I am attempting to build a ground station. After verifying my hardware
configuration worked with RadioLib's example, I started with your PingPong
program running on 2 seperate systems.
I needed to change SX1262 to RFM96.  Otherwise radio,begin() returned -2
(Chip not found).  I also changed radio.setDio1Action(setFlag) to
radio.setDia0Action(setFlag) in both places.  Doing so, my systems would
transmit but not receive.  (I verified using a UHF radio tuned to 436.7)

When I removed the sync word by changing radio.begin(436.7, 125.0, 11, 8,
0x0F0F) to radio.begin(436.7, 125.0, 11, 8)   the receiver worked as
expected.

Note when specifying the sync word in the begin function, the
compiler returned a warning "large integer implicitly truncated to unsigned
type".

Thanks for pointing me to the ground station code in FOSSASAT-1B as well as
G4lile0's code.  I'll investigate both.
I did a quick compile of your ground station code in FOSSASAT-1B.
FSK_DATA_SHAPPING and FSK_CURRENT_LIMIT  were undefined used in setGFSK().
I haven't tracked that problem yet.  I'm using RadioLib version 4.0.4

Thanks for your help.  I look forward to receiving data from FOSSASAT-1B
once deployed.
Please confirm reception of this email,

Fredric Raab
KK6NOW

On Tue, Oct 20, 2020 at 12:03 PM Jan Gromeš <notifications@github.com>
wrote:

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

jgromes, 2020-10-21:
> Note when specifying the sync word in the begin function, the
compiler returned a warning "large integer implicitly truncated to unsigned
type".

LoRa sync word handling on SX126x changed in RadioLib 3.0.0, to make it slightly harder for people (myself included) to set weird sync word that would be incompatible with SX127x. `SX126x::begin` method now only accepts 1-byte sync word, which is then split into nibbles and corrected to ensure SX127x compatibility. For example, if you set SX126x sync word to 0x12, it gets turned into 0x1424. which is somehow the same sync word as SX127x's 0x12.

If you want to specify the other nibbles, you have to use `SX126x::setSyncWord(sync, control)`, so to set FOSSASAT-1 sync word you'd call `SX126x::setSyncWord(0x00, 0xFF);`. I only added that for FOSSASAT-1 compatibility, and would advise against using that. FOSSASAT-1B and 2 will be using 0x12 sync word and are tested to be compatible with all sub-GHz LoRa transceivers.

> FSK_DATA_SHAPPING and FSK_CURRENT_LIMIT  were undefined used in setGFSK()
Oops, forgot to rename those macros - should be fixed now, thanks.

Thread 18 (2023-01-08):

Can output of SPV1040 DIrectly be connected to Lion battery?

nilavghosh, 2023-01-08:
Hi, I could not find reference that the SPV1040 can be used directly as a CC CV LiON battery charger. Although in the circuit, you have directly connected it to the battery. Should we not hook up SPV1040 with a CC CV LiOn charger IC?

Another point is that R1 and R2 would make the output be 3.7V which is not the max voltage the battery can be charged upto. Is it a conscious decision or am I missing something?

Referring this :
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

nilavghosh, 2023-03-04:
Closing the issue. The value of R1 and R2 leads to a constant voltage of 4.2 volts which is ideal to charge the LiOn battery. was my calculation mistake.

Closed 2023-03-04.

Thread 19 (2023-03-26):

"SX1278T" Transciever?

MatthewVerbryke, 2023-03-26:
Hello,

I'm currently researching transceivers for nano/pico-satellites. Looking at your design for FOSSASat-1's beacon, the BOM and schematic say that the transceiver is a "SX1278T", with a SX1262/68 footprint. Based on your flight hardware pictures this seems to be some sort of PCB breakout board using the Semtech SX1278. However, searching the internet I haven't found anything with the specific model name "SX1278T".

What model exactly did you use for this project?
