FOSSASystems/FOSSASAT-1/Hardware/Beacon/Schematic_PCBBeaconv4_Sheet_1_20191204195255.pdf

## DEPLOYMENT FET

UTILITY HEADER | PROGRAMMING HEADER

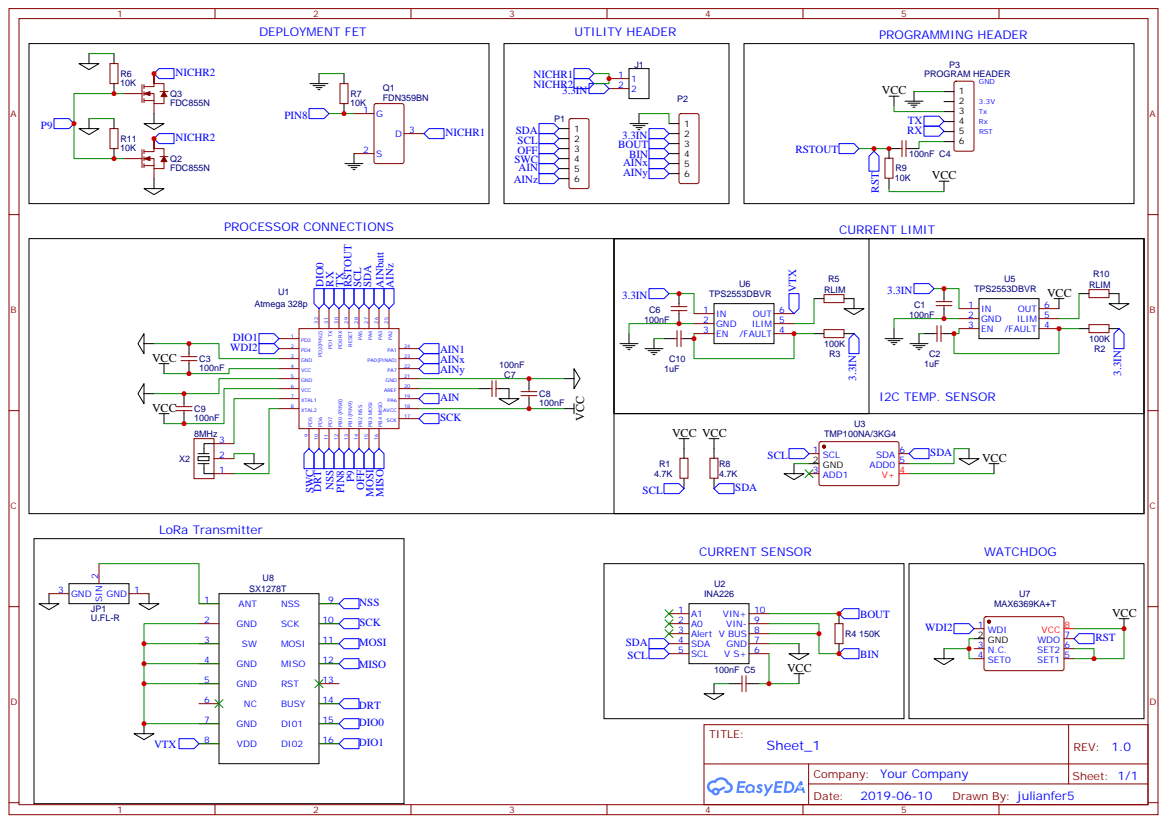
[picture p55: page 1]
