FOSSASystems/FOSSASAT-1/Hardware/Frame/folded.pdf

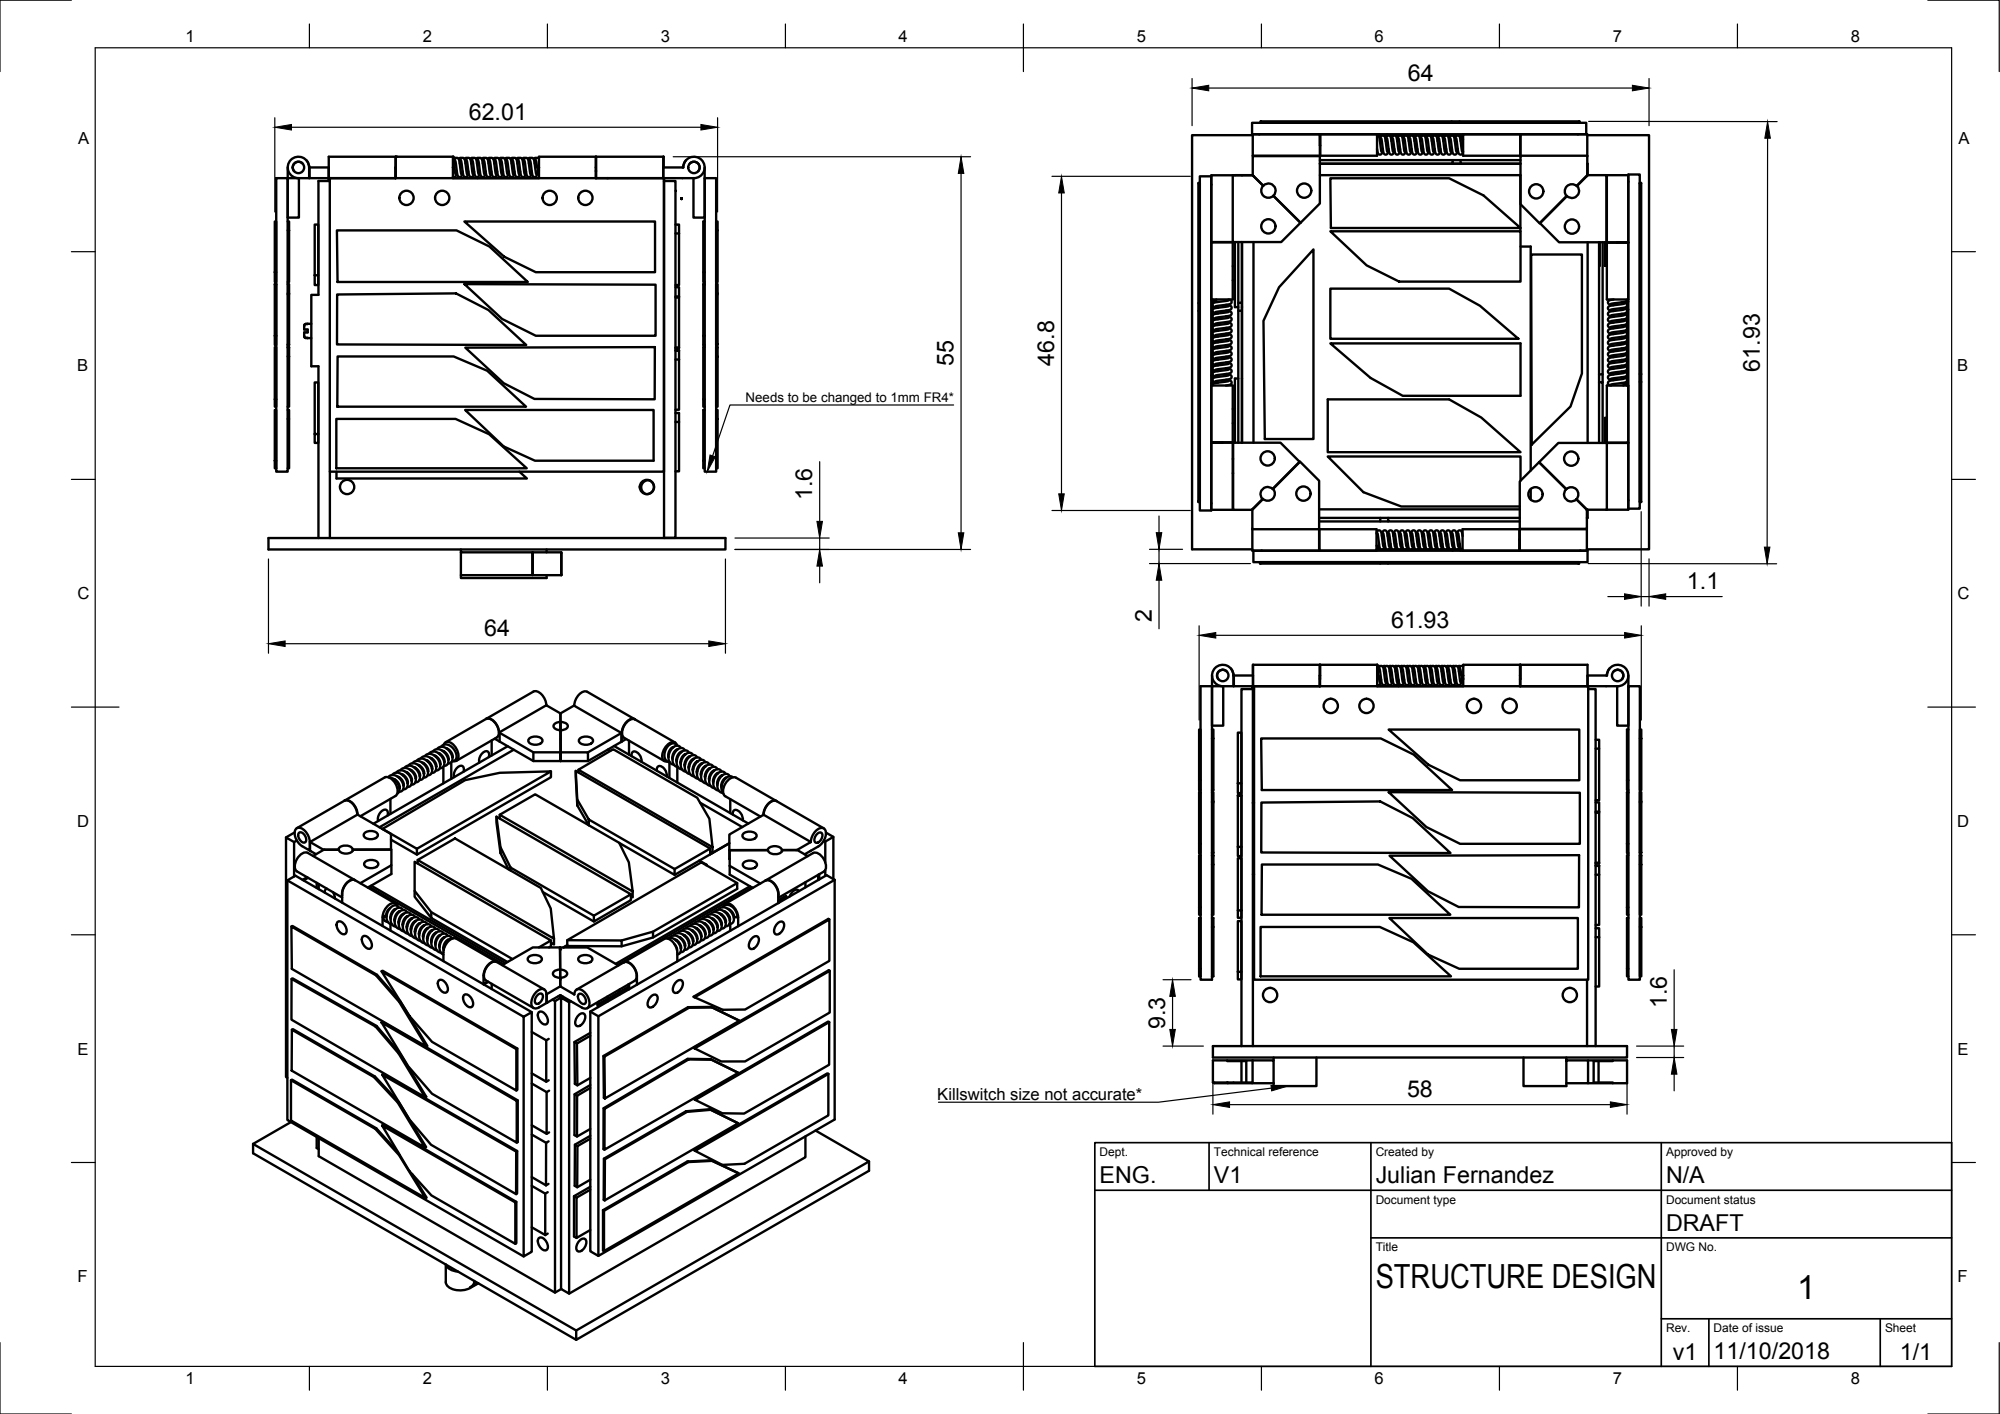
[picture p56: page 1]
Dept.; Technical reference; Created by; Approved by; Document type; Document status; Title; DWG No.; Rev.; Date of issue; Sheet; 1 STRUCTURE DESIGN; ENG.; Julian Fernandez

Needs to be changed to 1mm FR4*

Killswitch size not accurate*
