FOSSASystems/FOSSASAT-1/FossaCube Files/FOSSACUBE/SCHEMATICS/Schematic_MPPTBOARD.pdf

# MPPT POWER SYSTEM / DiceyTech Kits

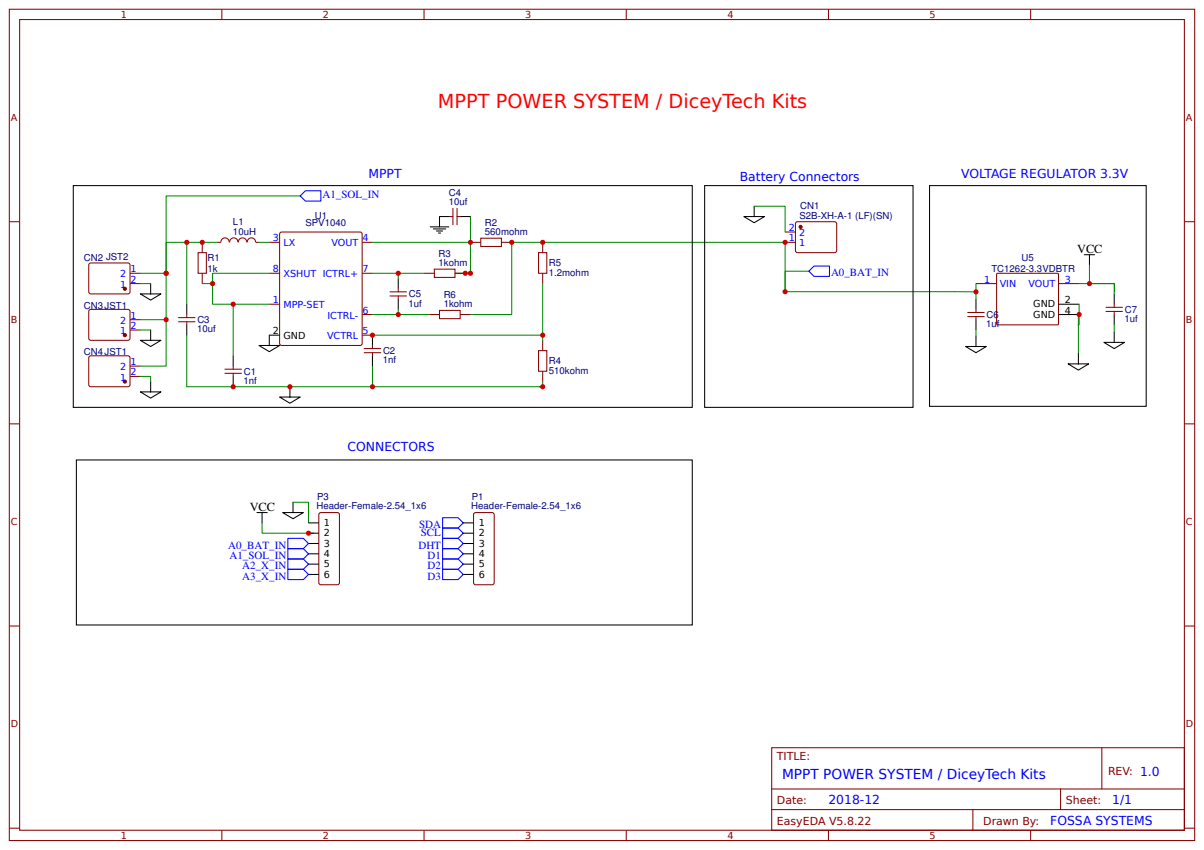
[picture p57: page 1]
