FOSSASystems/FOSSASAT-1/FossaCube Files/FOSSACUBE/SCHEMATICS/Schematic_OBCBOARD.pdf

+5V

## VCC

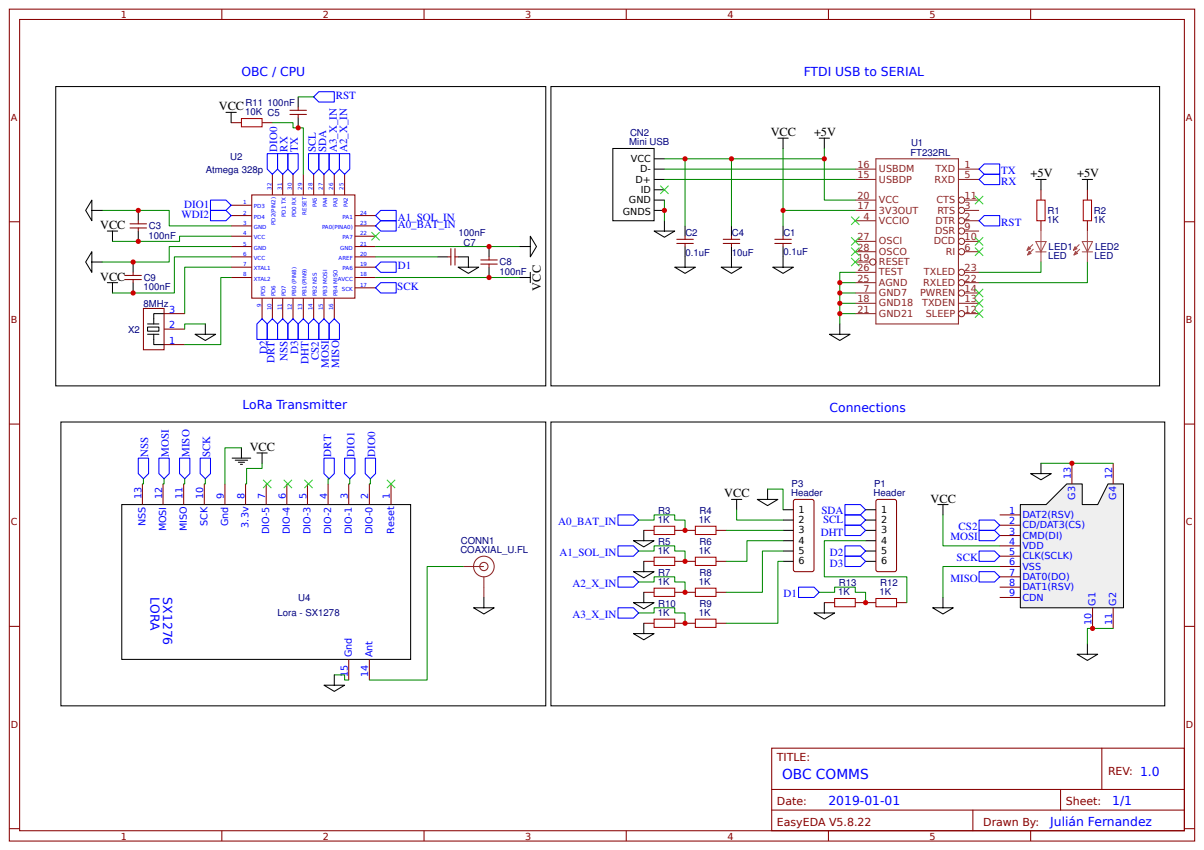
[picture p58: page 1]
