FOSSASystems/FOSSASAT-1/FOSSA Documents/Separation Diagram.pdf

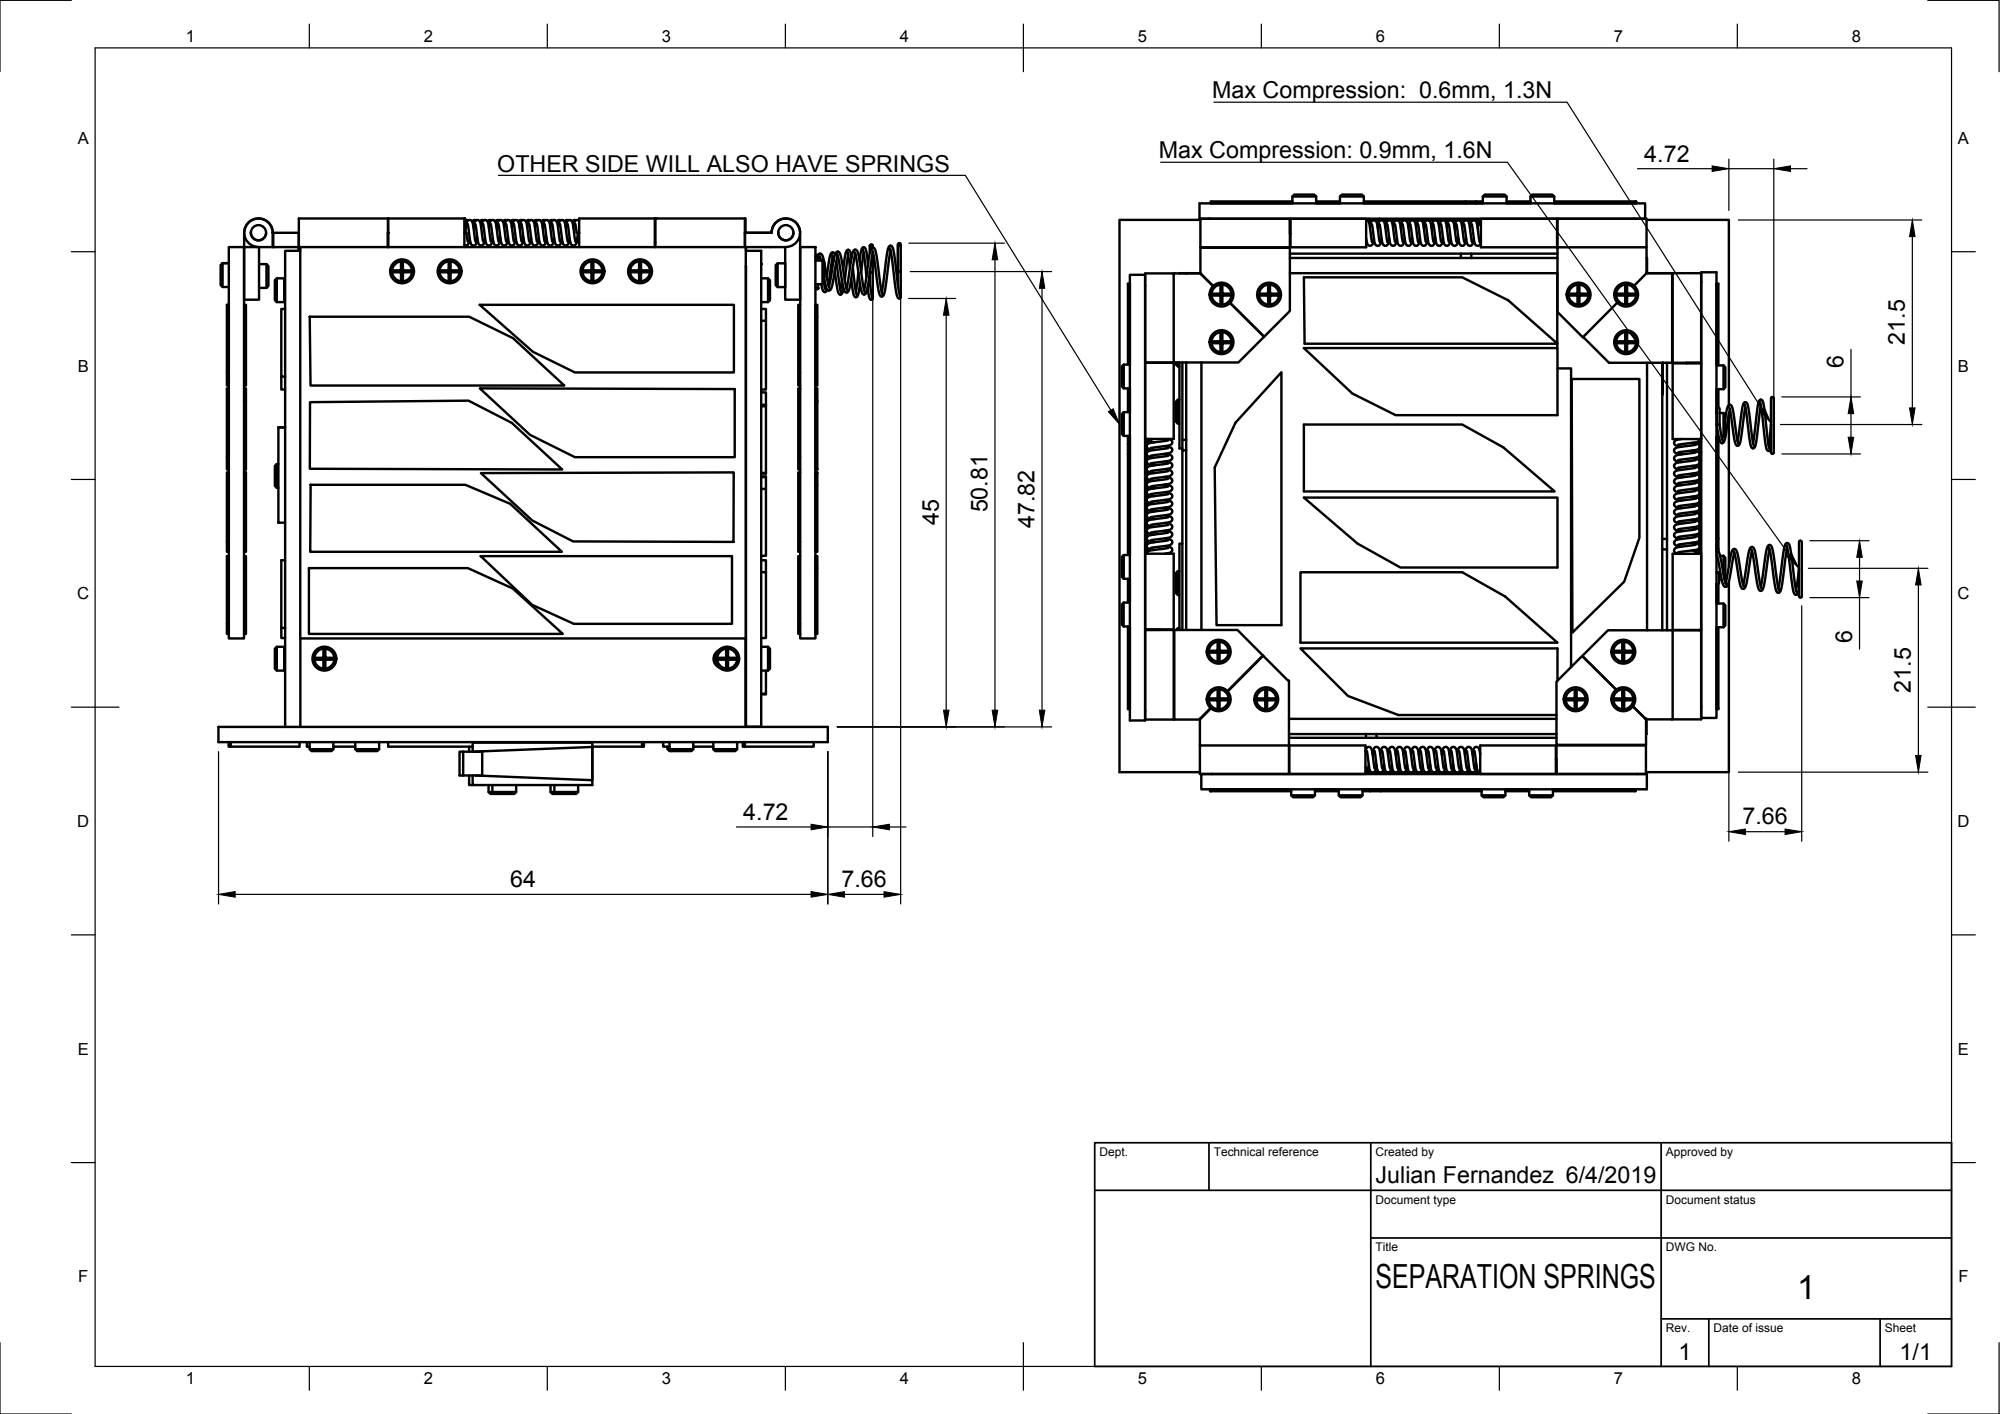
[picture p59: page 1]
Max Compression: 0.6mm, 1.3N; Max Compression: 0.9mm, 1.6N 50.81 45

OTHER SIDE WILL ALSO HAVE SPRINGS

Dept. | Technical reference | Created by Julian Fernandez 6/4/2019 | Approved by

Document type | Document status

Title | DWG No. 1 SEPARATION SPRINGS

Rev. 1 | Date of issue | Sheet 1/1
