FOSSASystems/FOSSASAT-1/Hardware/Frame/exterior view.pdf

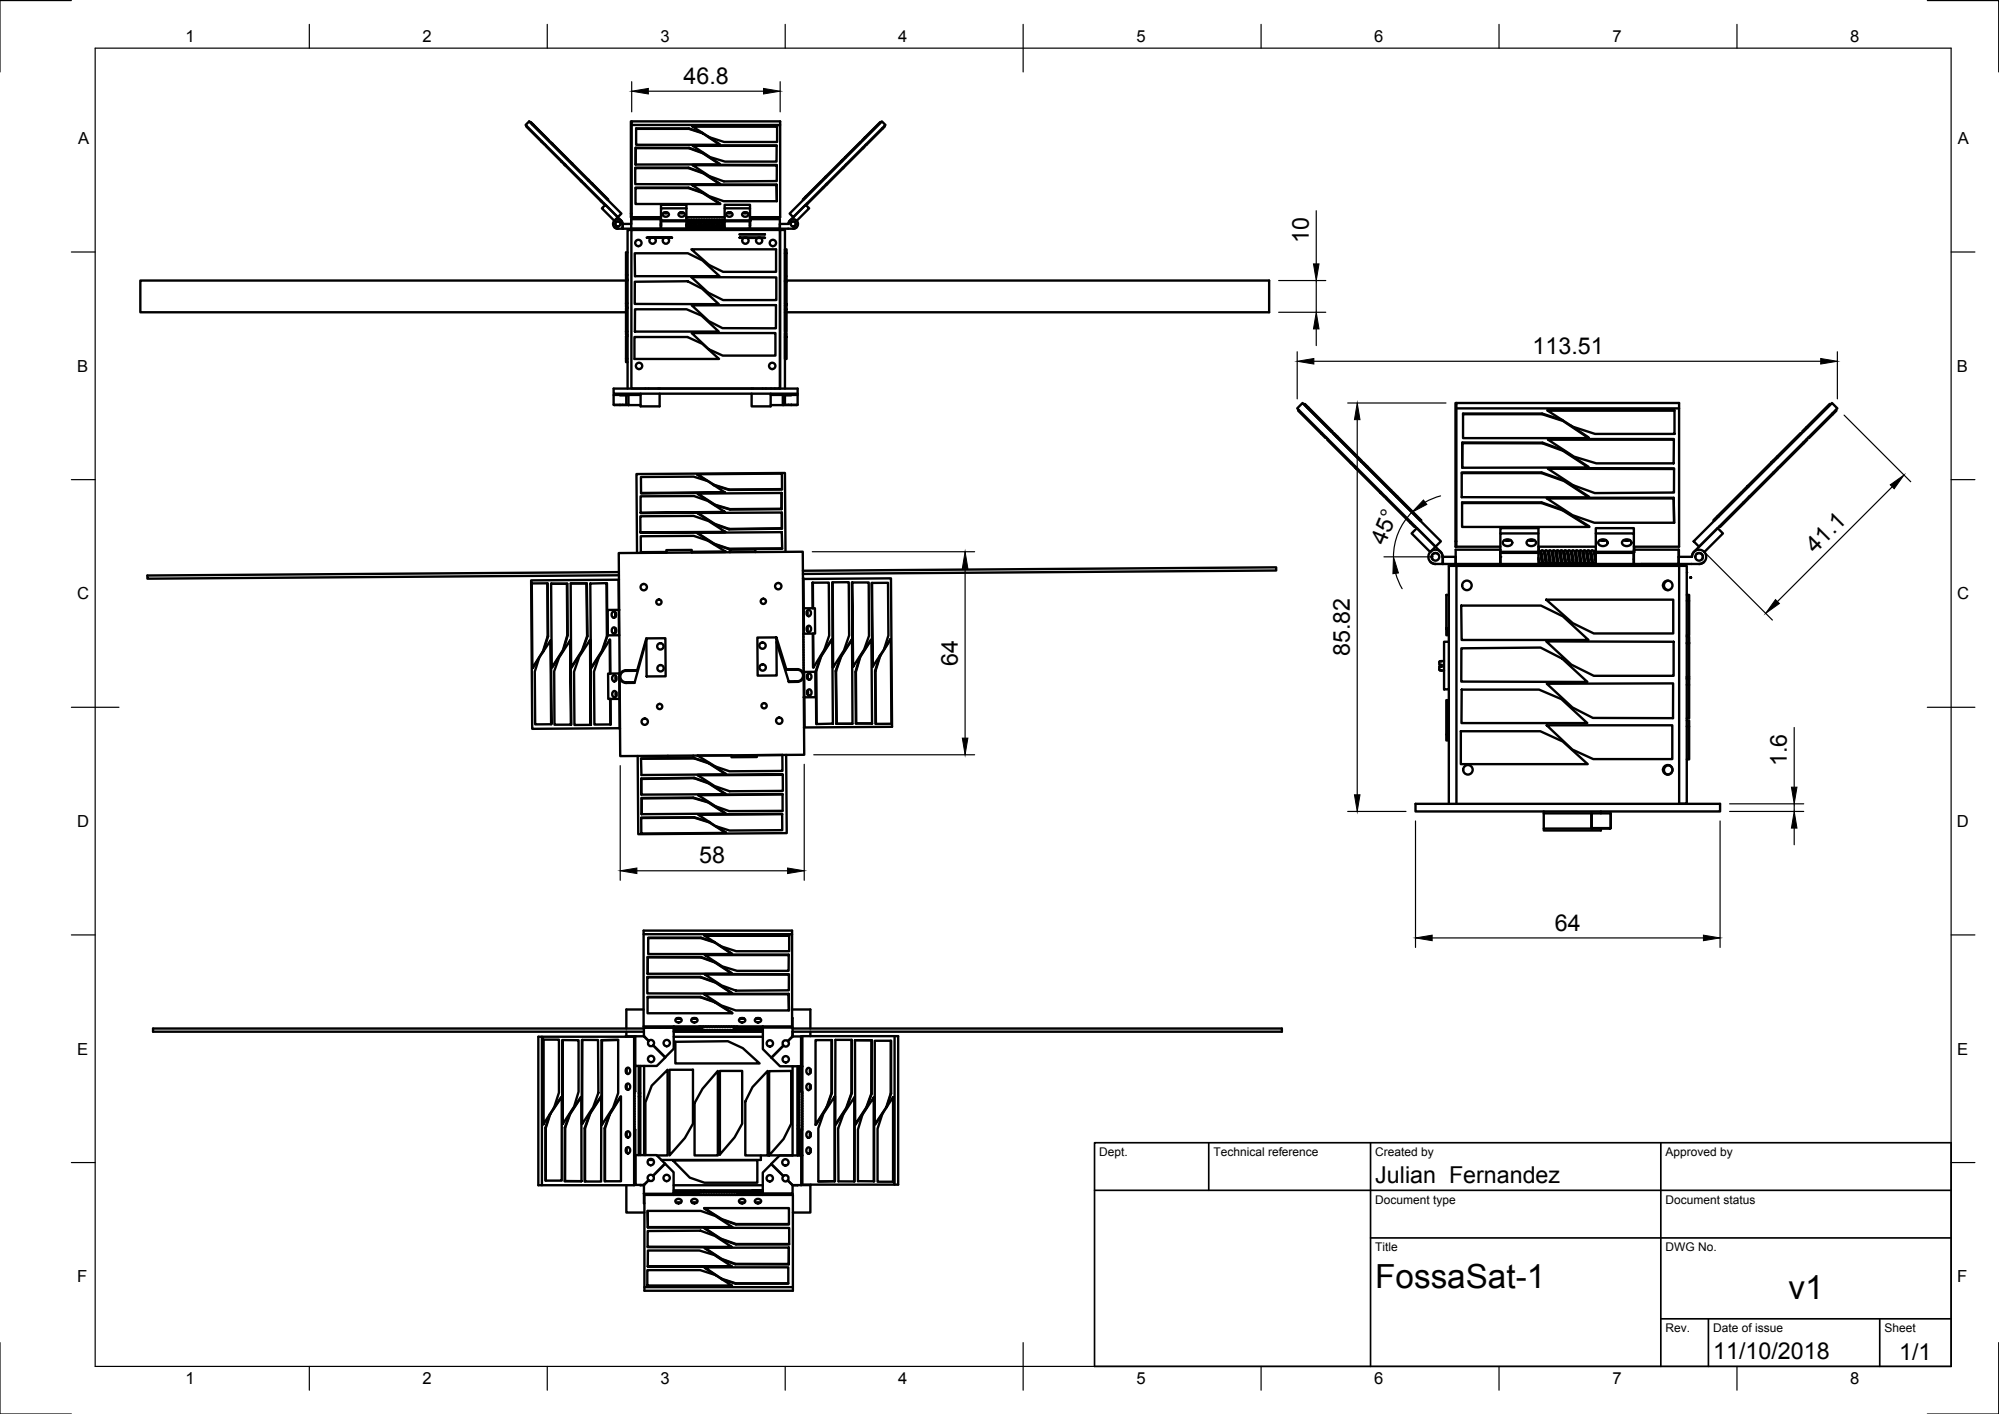
[picture p60: page 1]

Dept. | Technical reference | Created by Julian Fernandez | Approved by

Document type | Document status

Title | DWG No. v1 FossaSat-1

Rev. | Date of issue 11/10/2018 | Sheet 1/1
