FOSSASystems/FOSSASAT-1/FossaCube Files/FOSSACUBE/SCHEMATICS/PCB_BEACON.pdf

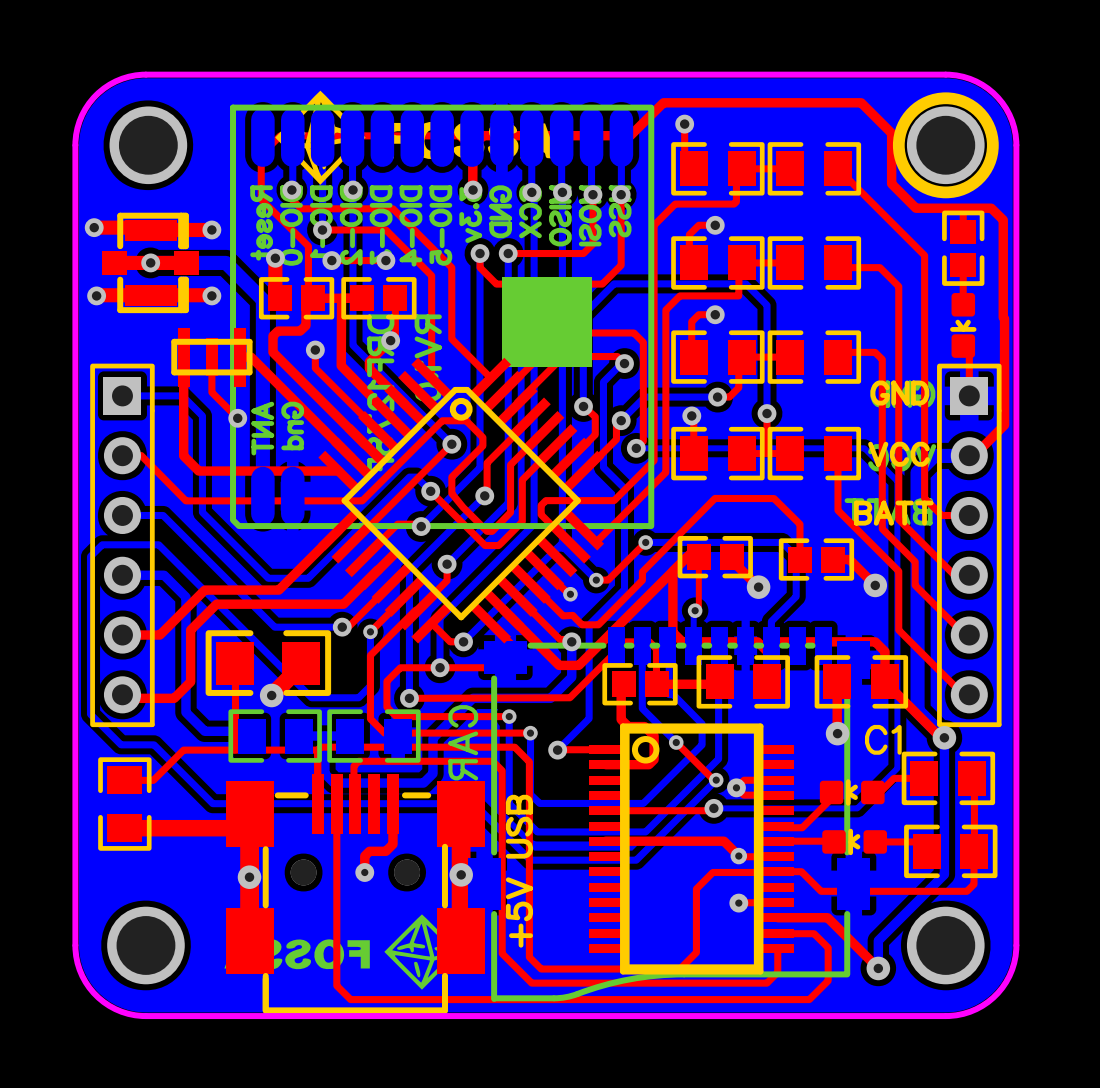
[picture p61: page 1]
