FOSSASystems/FOSSASAT-1/FossaCube Files/FOSSACUBE/SCHEMATICS/PCB_Breakout.pdf

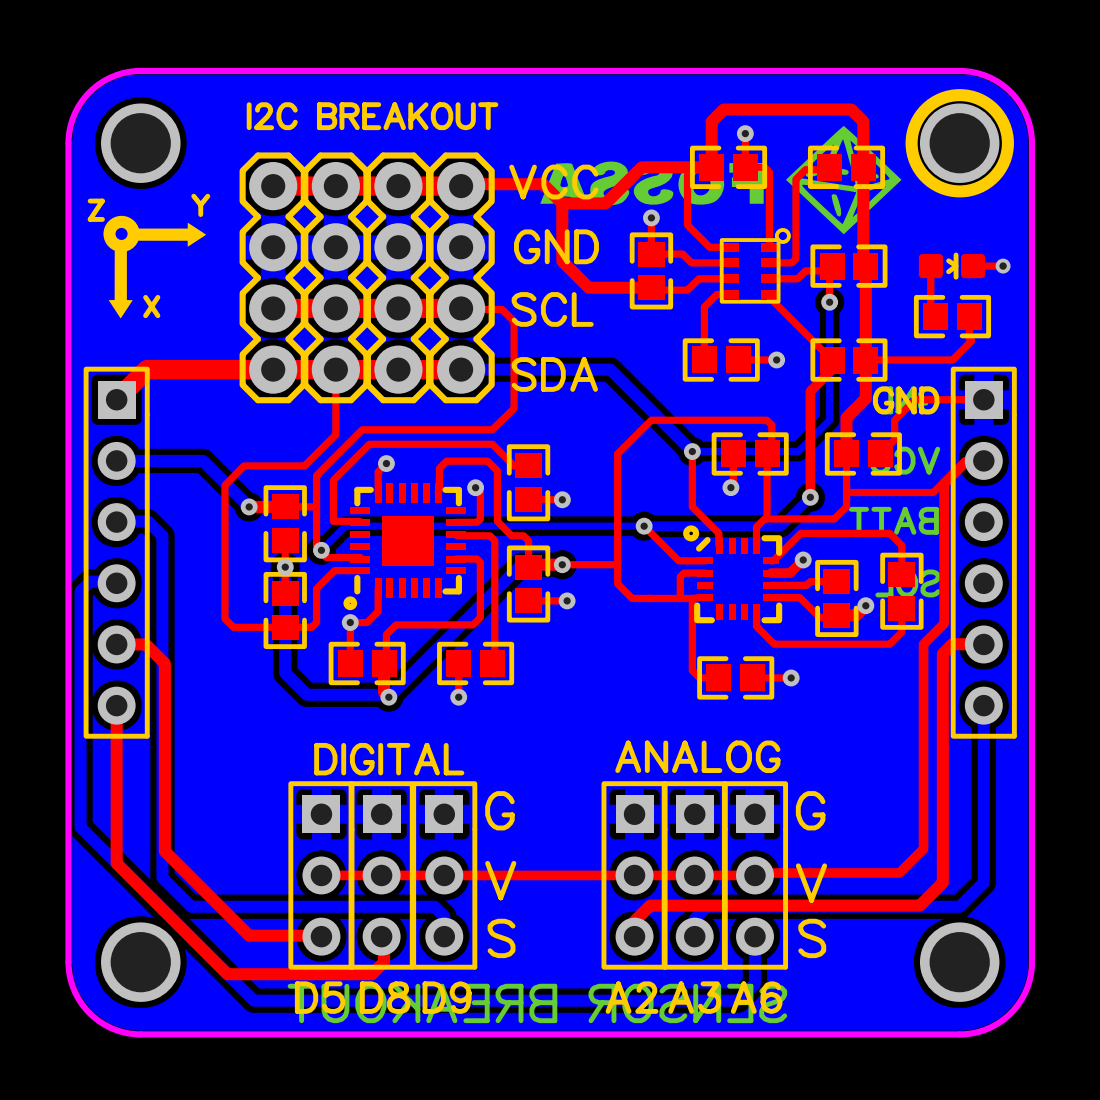
[picture p62: page 1]
