FOSSASystems/FOSSASAT-1/FossaCube Files/FOSSACUBE/SCHEMATICS/PCB_GPS.pdf

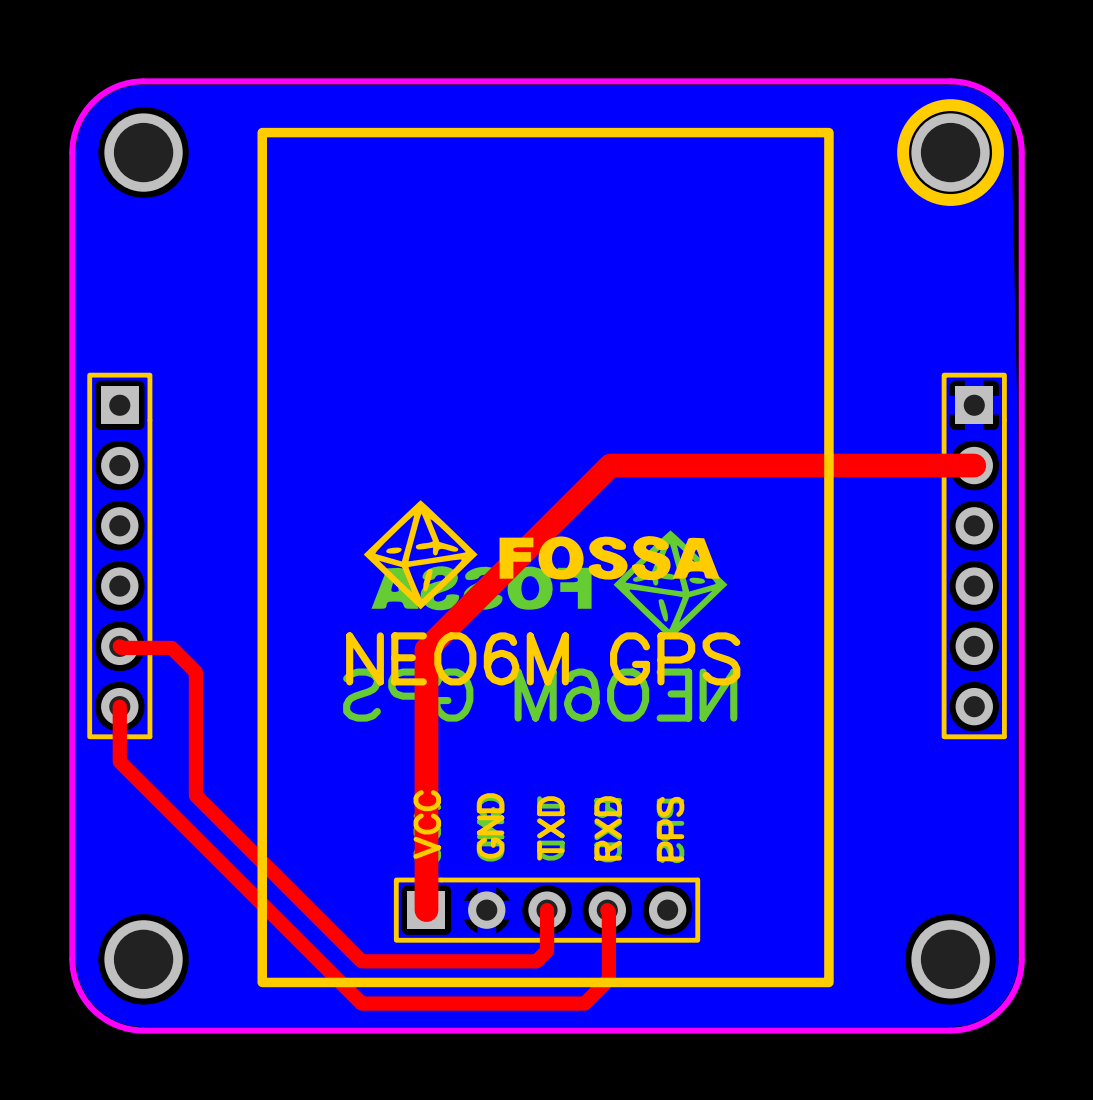
[picture p63: page 1]
