FOSSASystems/FOSSASAT-1/FossaCube Files/FOSSACUBE/SCHEMATICS/PCB_MPPT.pdf

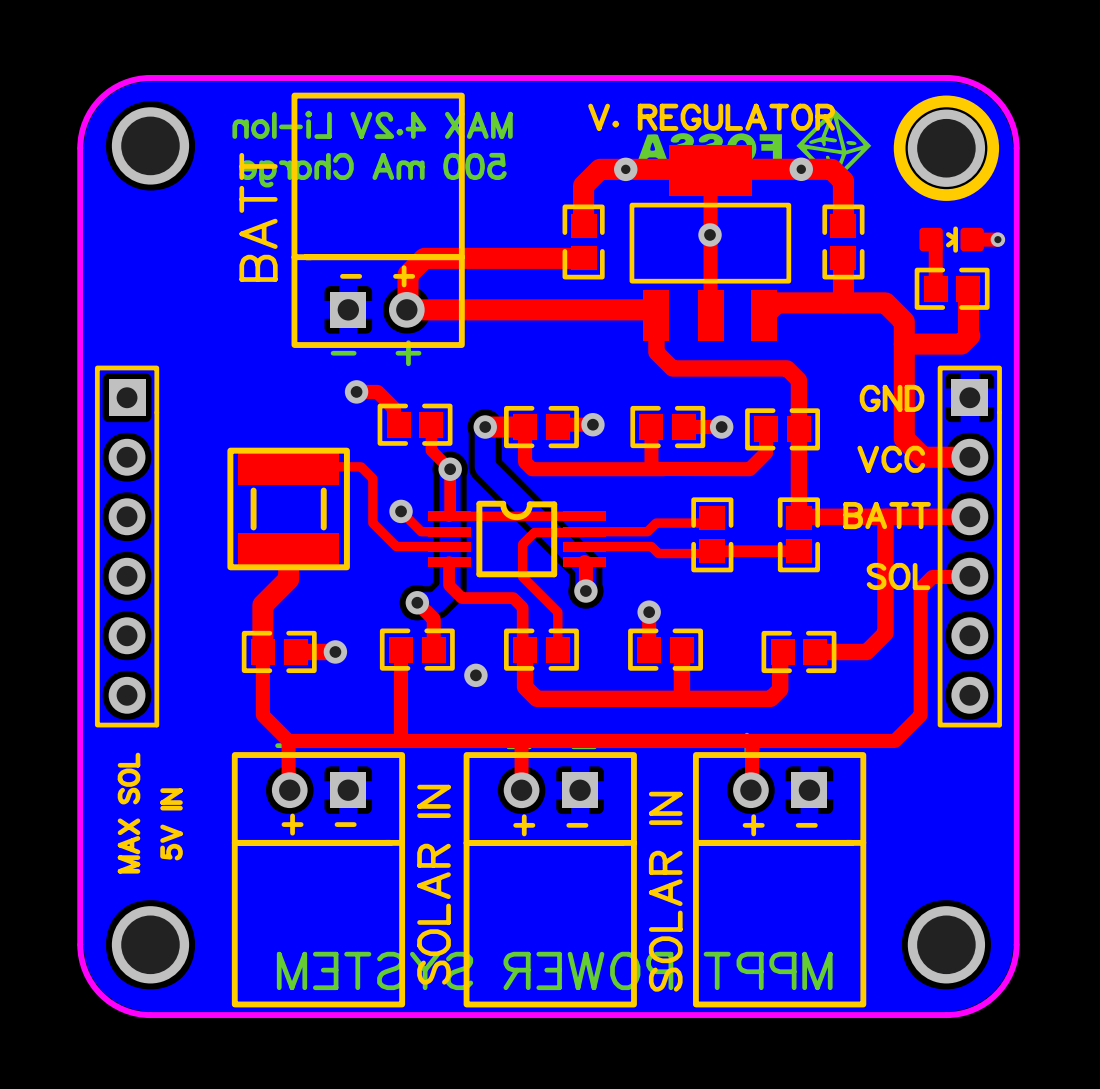
[picture p64: page 1]
