FOSSASystems/FOSSASAT-1/FossaCube Files/FOSSACUBE/SCHEMATICS/Schematic_SENSORS.pdf

## VCC

## VCC

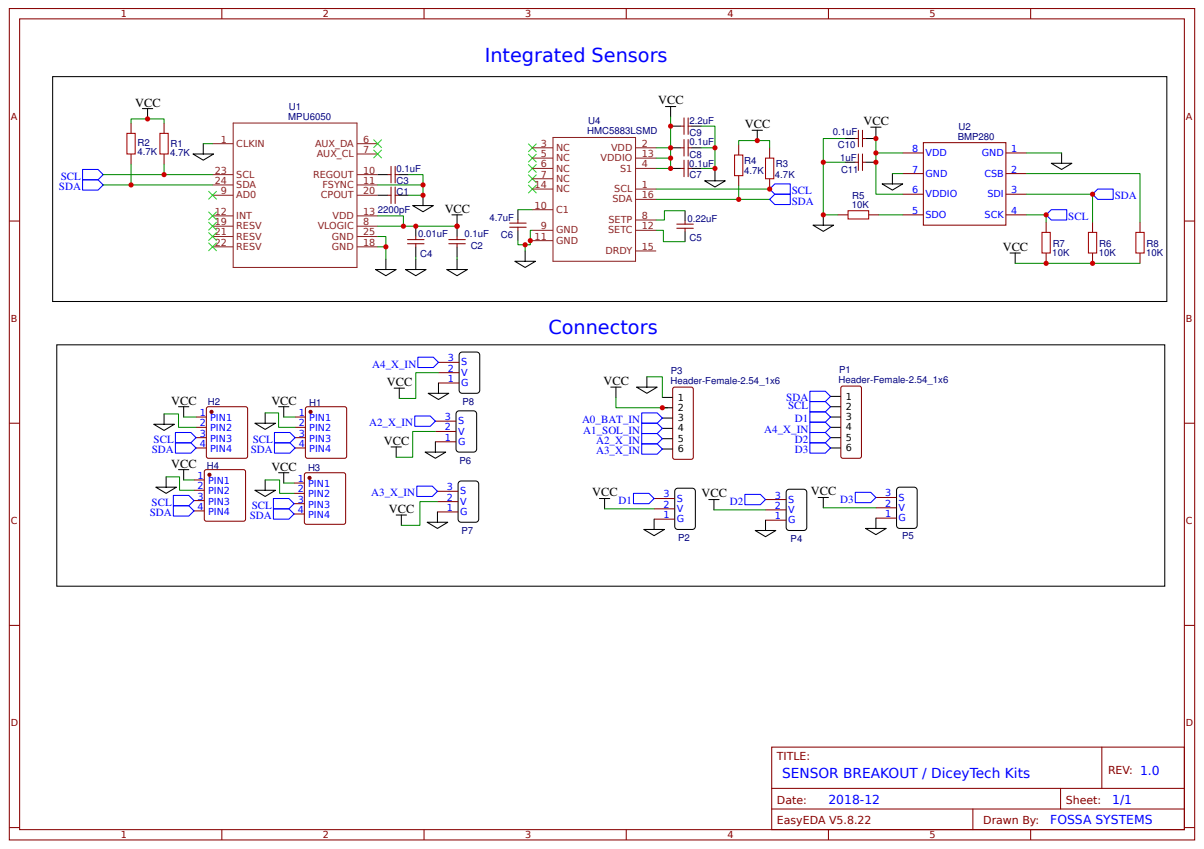
[picture p65: page 1]
