FOSSASystems/FOSSASAT-1/Code/Documentation/Ground Station/doxygen documentation/latex/ground__station_8cpp_afe461d27b9c48d5921c00d521181f12f_cgraph.pdf

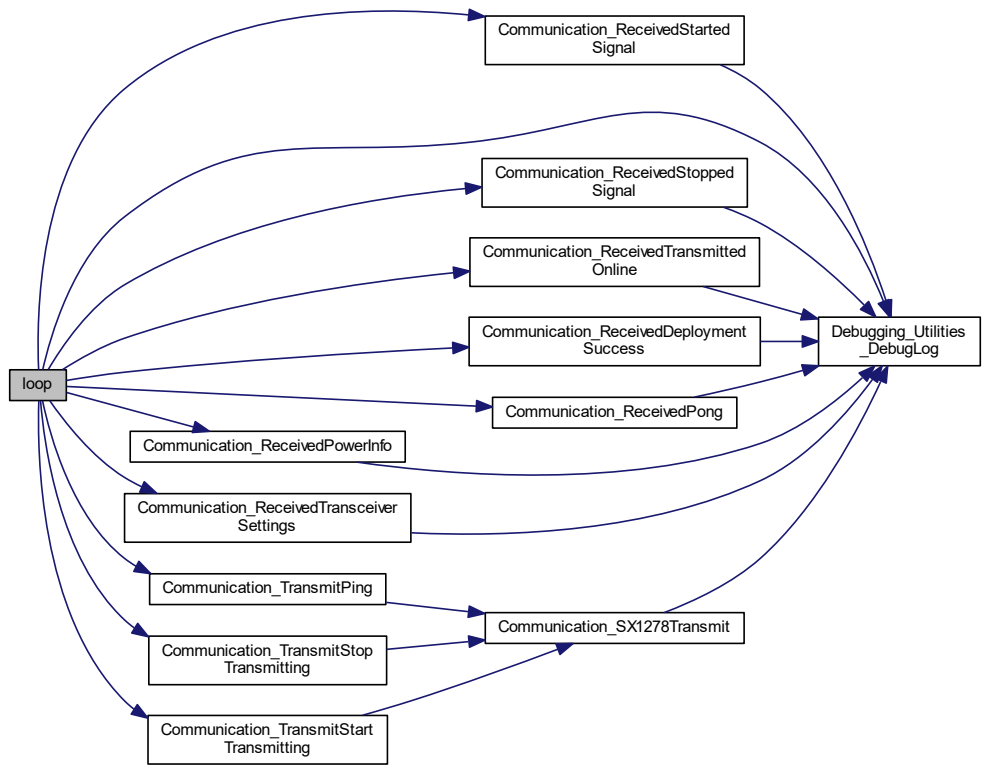
[picture p66: page 1]
loop; Communication_ReceivedStarted Signal; Debugging_Utilities _DebugLog; Communication_ReceivedStopped Signal; Communication_ReceivedTransmitted Online; Communication_ReceivedDeployment Success; Communication_ReceivedPong; Communication_ReceivedPowerInfo; Communication_ReceivedTransceiver Settings; Communication_TransmitPing; Communication_TransmitStop Transmitting; Communication_TransmitStart Transmitting; Communication_SX1278Transmit
