FOSSASystems/FOSSASAT-1/Code/FossaSat1/FossaSat1.h

// C++ libraries
#include <string.h>

// Arduino libraries
#include <Wire.h>

// FOSSA libraries
#include <FOSSA-Comms.h>

// contributed libraries
#include <AESLib.h>
#include <INA226.h>
#include <LowPower.h>
#include <RadioLib.h>
#include <TimerOne.h>

// files
#include "communication.h"
#include "configuration.h"
#include "debugging_utilities.h"
#include "deployment.h"
#include "persistent_storage.h"
#include "pin_interface.h"
#include "power_control.h"
#include "system_info.h"
