FOSSASystems/FOSSASAT-1/Code/FossaSat1/persistent_storage.h

#ifndef PERSISTENT_STORAGE_H_INCLUDED
#define PERSISTENT_STORAGE_H_INCLUDED

#include "FossaSat1.h"

template <class T>
T Persistent_Storage_Read(uint16_t addr);

template <class T>
void Persistent_Storage_Write(uint16_t addr, T val);

void Persistent_Storage_Wipe();

#endif
