FOSSASystems/FOSSASAT-1/Code/FossaSat1/system_info.h

#ifndef SYSTEM_INFO_H_INCLUDED
#define SYSTEM_INFO_H_INCLUDED

#include "FossaSat1.h"

void System_Info_Set_Callsign(char* newCallsign);
void System_Info_Get_Callsign(char* buff, uint8_t len);

#endif
