FOSSASystems/FOSSASAT-1/(commit log)

2018-07-21 Imported previous work.
    [Frame.f3d, Frame.stl, Schematic DRAFT.schdoc]
2018-07-22 Split the beacon code into multiple files for readability.
    [configuration.h]
2018-07-22 Version 1 of the beacon system
    - LORA tranmissions connected
    [configuration.h]
2018-07-23 Ground station beta code.
    [configuration.h]
2018-07-23 ground station receive code fixed.
    - Now takes into account the number "10" when extracting the function_id, message and signature.
    [configuration.h]
2018-07-26 implement optional transmission bool.
    - enabled or disable at line 15 in configuration.h on both the beacon and ground station code.
2018-07-28 Transmitting carrier frequency packets to ground station, timers on power info and frequency info.
2018-07-28 added transceiver automatic frequency tuning and bandwidth tuning.
    [configuration.h]
2018-07-28 implemented tuning packet transmission on beacon.
    [configuration.h]
2018-07-29 Uploaded PCB
2018-07-29 Added doxygen config. Added documentation to ground station comms and conf files.
2018-07-29 Uploaded Schematic & Gerber
2018-07-30 Ground station and transmission protocol documentation.
    - Added transmission/function_id explaination and descriptor to the mainpage of the doxygen website.
    - Completed the documentation of the ground station code and extracted testing and todo requirements.
2018-07-30 Full documentation structure re-haul, added flow charts, added more doxygen descriptions.
2018-07-31 Finialized documentation for the beacon and flowchart generated for the ground station.
2018-07-31 Added 3D CAD model images to document.
2018-07-31 MPPT BOM
    [MMPT_BOM_FOSSASAT.xlsx]
2018-07-31 Uploaded BEACON BOM
    [BEACON_BOM_FOSSASAT.xlsx]
2018-07-31 Uploaded v1.1 schematic
2018-07-31 Uploaded new beacon schematics
2018-08-02 version 1 of the online javascript simulator prototype.
    - User interface operational.
    - Requires backend file and simulator classes.
2018-08-02 updated docs and ignored doc files in compilation
    [configuration.h]
2018-08-02 formatted code to use 4 spaces wide indention and added more debug prints.
2018-08-03 Fixed error in transmission substring-ing "S" instead of ";" after function id part.
    [communication.cpp, ground_station.ino]
2018-08-03 Ground station re-tunes to MHz now.
2018-08-03 Added more debug prints to beacon.
2018-08-03 Initial prototype html5 and css for the online simulator.
2018-08-05 added online simulator prototype, Beacon EEPROM fixed, temp reading transmitting and more debug prints.
    [communication.cpp, deployment.cpp, system_info.cpp, system_info.h]
2018-08-07 added communication relay for serial reading from payload. remove competition documents for now.
2018-08-07 temp while loop catch removed, added i2c requesting to payload and response.
2018-08-10 Analog pin layout changed, communication now maps values to voltages,
    [configuration.h]
2018-08-10 increased wait times between transmission and I2C buffer reading, added "DEC" definition to string conversions.
2018-08-11 made i2c bus optional and disabled by default.
2018-08-11 Debug prints less characters to save memory.
2018-08-11 rounding added to system power info transmissions, pin layout changed.
    [configuration.h]
2018-08-11 added batteryChargingVoltage (measures current) conversion.
2018-08-11 fixed variable name error.
    [communication.cpp]
2018-08-11 Added pin setup function.
2018-08-12 Added transmitting state to EEPROM system, will restort transmission state between restarts.
    [configuration.h]
2018-08-12 Changed the voltage divided analog input mapping.
2018-08-16 added prototype pc ground station control panel
2018-08-20 added modulation modes FSK and LoRa to the program. Waiting for lib author for RTTY compat.
    [configuration.h]
2018-08-20 Implemented RTTY communication at base = 2125.0Hz and mark at 2295Hz
    [configuration.h]
2018-08-20 use ints instead of floats to denote base and shift frequencies
    [configuration.h]
2018-08-20 switching back to packet mode after RTTY transmission.
2018-08-21 Uploaded Technical Drawings
    [HINGE1 v2 (1).step, hinge2 v3 (1).step]
2018-08-22 switch directMode() calls to tone(), added delays between switching modem modes (100ms), add pin for SX1278 DIO2 for direct mode.
    [configuration.h]
2018-08-22 added test transmission, fixed configuration, added names to switching modes.
    [communication.cpp, configuration.cpp]
2018-08-22 renamed some debug prints, switched byte state to int state.
2018-08-22 sync word shortened to 4 - 0x0Fs
    [communication.cpp]
2018-08-22 switch from tone calls to LORA.directMode() overrides.
2018-08-22 reverted back to tones
    [communication.cpp]
2018-08-22 reverted to tone() frequencies
    [configuration.cpp]
2018-08-25 switch mark to lower sideband
2018-09-09 Added schematic & PCB
2018-09-09 Uploaded all PCB solar panels & MPPT
2018-09-09 Added complete satellite CAD
    [fossasat-1-MOCKUP.f3d]
2018-09-09 Added Upper and Lower structure CAD
    [STRUCTURE UPPER FOSSASAT-1 v2.f3d, stucture lower fossasat v2.f3d]
2019-06-02 Uploaded Calculator
    [Solar Calculator.xlsx]
2019-10-17 Cleanup and format
    [NA.xlsx, configuration.h]
2019-10-18 Removed legacy code
    [configuration.h]
2019-10-18 Renamed current code
    [configuration.h]
2019-10-18 Moved all docs to FOSSA Documents, removed outdated docs
    [NA.xlsx]
2019-10-18 Simplified folder structure
    [configuration.h]
2019-11-01 Removed old ground station code
    [configuration.h]
2019-11-04 ground station can now transmit to the satellite
2019-11-04 ground station can now read transmissions it receives
2019-11-04 Added new ground station demo code
2019-11-20 Simplified ground station radio configuration
2019-11-20 Added simulator code
    [configuration.h]
2019-11-27 Updated for RadioLib 2.0.0
    [configuration.h]
2019-11-28 Fixed compatibility with RadioLib 2.0.0
    [configuration.h]
2019-11-28 Fixed printing message in ground station (#6)
    [GroundStation.ino]
2019-12-04 Added Gerbers & Documents
    [BEACON_BOM_FOSSASAT With Hyperlinks.xlsx, BEACON_BOM_FOSSASAT.xlsx, BISAGRA1(IMPRIMIR 5) (1).ipt, BISAGRA2(IMPRIMIR5) (1).ipt, BISAGRA3(IMPRIMIR9) (1).ipt, BISAGRADOBLE(IMPRIMIR 5) (1).ipt, BOM_PCBBeaconv4_20191204195310.csv, Frame.f3d]
2019-12-09 Dropped support for SX127x-based ground stations (#10)
